ThomasKramp/kaarten_shieter/README.md

# kaarten_shieter
The documentation can be found in the Portfolio.

The PDF was generated using:
- The PDF version of the .md file Portfolio.
- An online md to pdf converter Converter
