ThomasKramp/kaarten_shieter/project_v2/feedback.docx

Elektronisch schema:

- Noteren welke connector waarvoor dient. O.a. power: input/output?
- Waar is de voeding? Extern?
- CE5: 470uF, waarom aan EN_P?
- Horizontale motor: 3,3V is dit correct?
- 470uF ontkoppeling aan ESP32 ontbreekt nog steeds.
- AISEN,BISEN: per pin één weerstand.

PCB:

- Montagegaten?
- Boorgaten: voor elecrow: stappen van 0,1mm (Zie DRL file)
- CE5 overlapt rand
- Design rules niet vergeten in te stellen. Clearance rule, annular ring rule geeft errors!
