ThomasKramp/kaarten_shieter/Portfolio/Images/module.jpeg

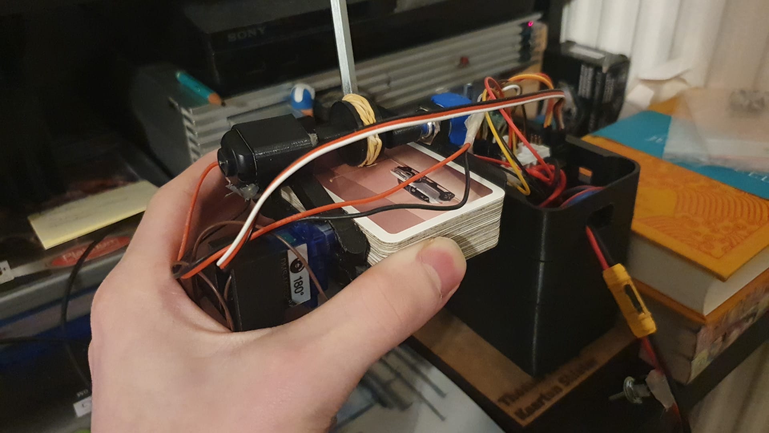
Portfolio/Images/module.jpeg
