ThomasKramp/kaarten_shieter/probleem_voeding/1_beginspanning_bron.png

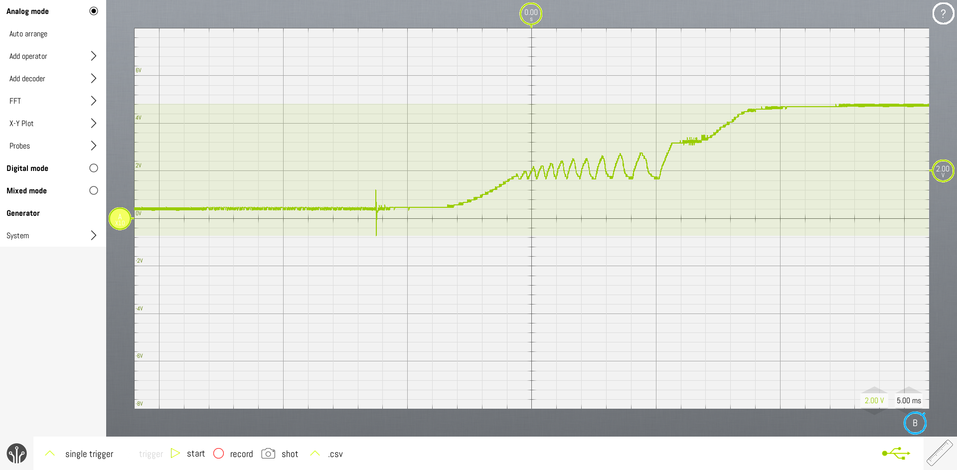
probleem_voeding/1_beginspanning_bron.png
