ThomasKramp/kaarten_shieter/probleem_voeding/2_beginspanning_batterij.png

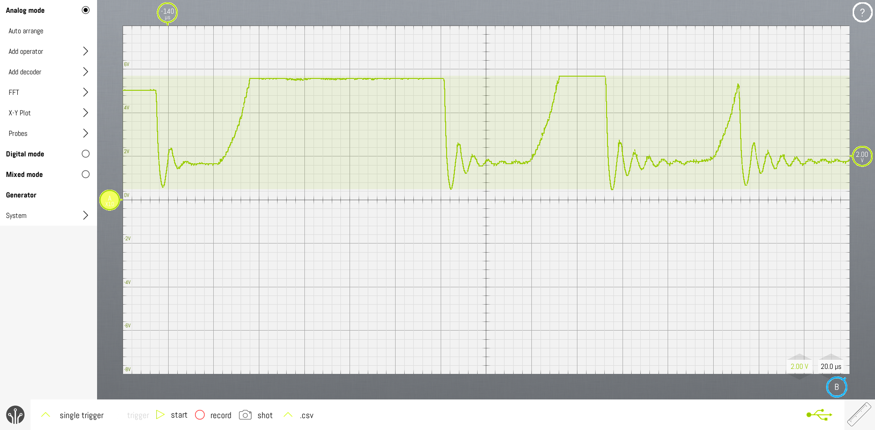
probleem_voeding/2_beginspanning_batterij.png
