ThomasKramp/kaarten_shieter/probleem_voeding/3_voeding_batterij.png

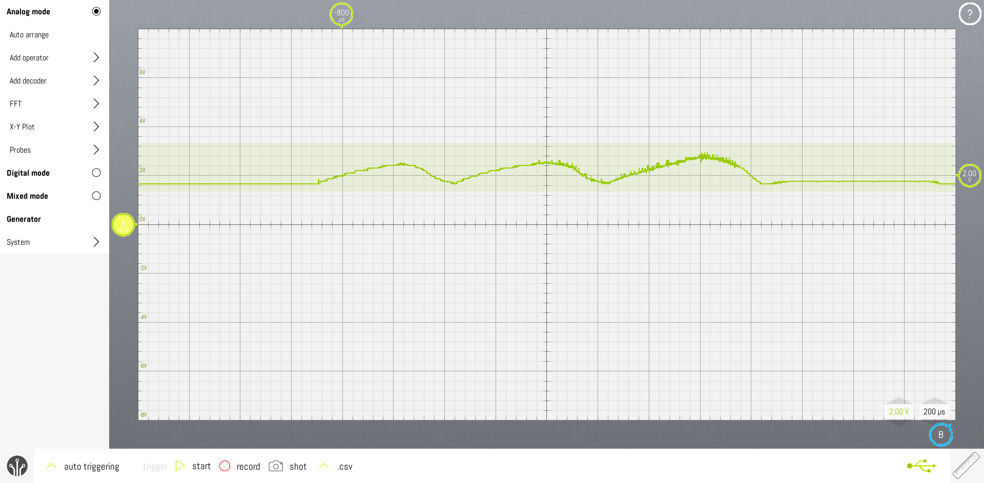
probleem_voeding/3_voeding_batterij.png
