ThomasKramp/kaarten_shieter/project_v3/back.png

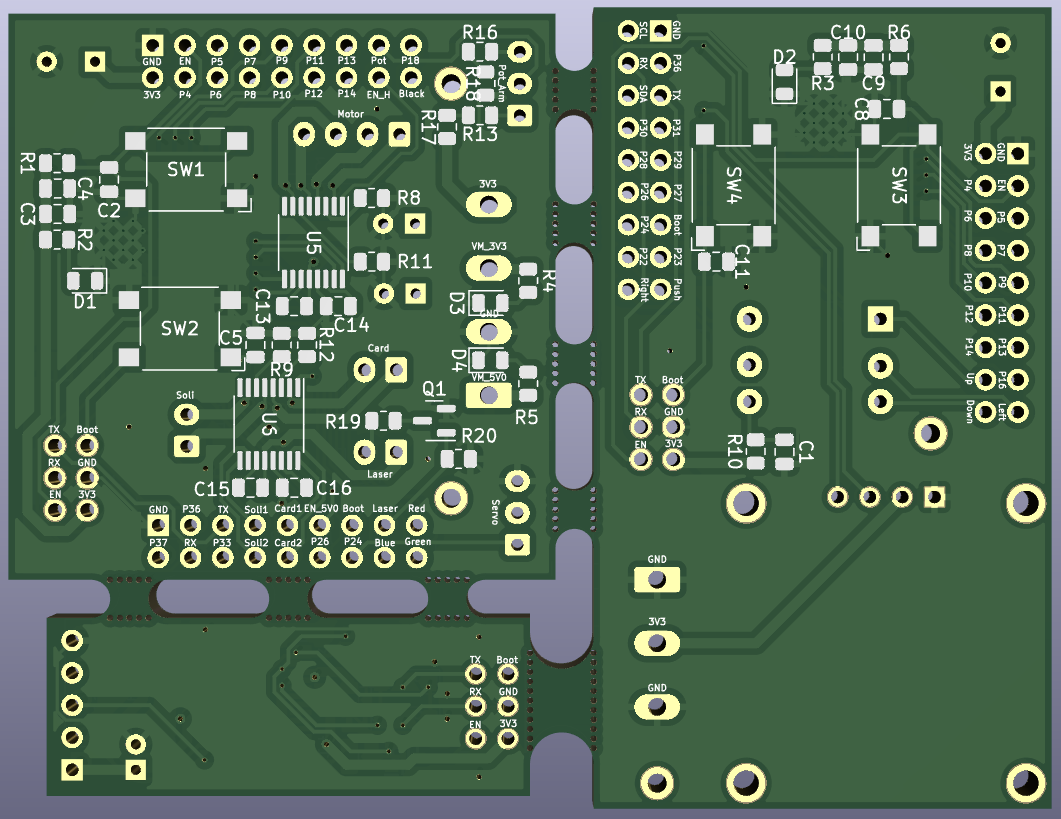
project_v3/back.png
