ThomasKramp/kaarten_shieter/project_v3/front.png

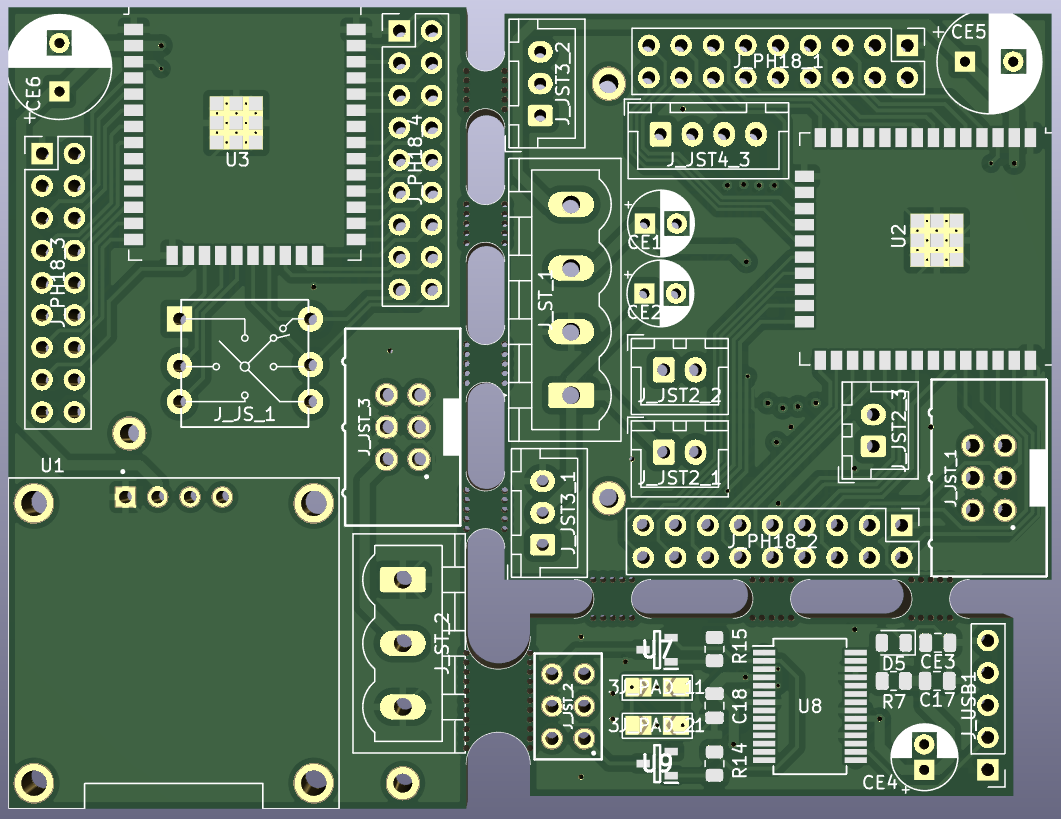
project_v3/front.png
