ThomasKramp/kaarten_shieter/3d_casing/stl/5_card_wheel.stl

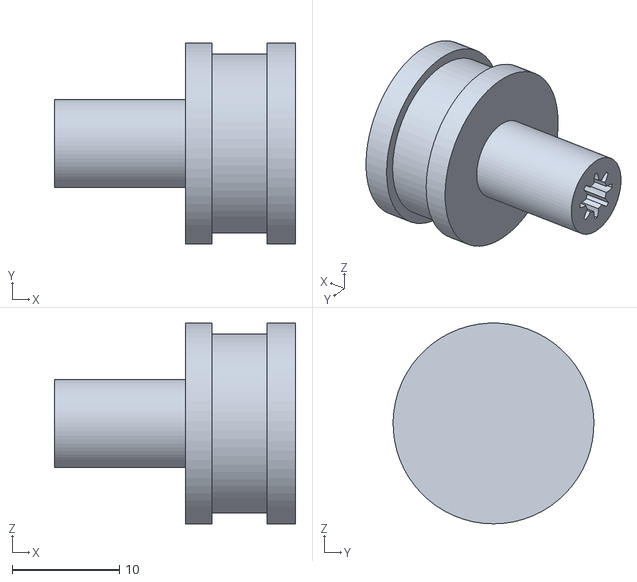
[picture p54: CAD file, 2025-01-09]
3d_casing/stl/5_card_wheel.stl
22.5 x 18.7 x 18.7
