ThomasKramp/kaarten_shieter/3d_casing/version_2/stl/4_sensor_holder.stl

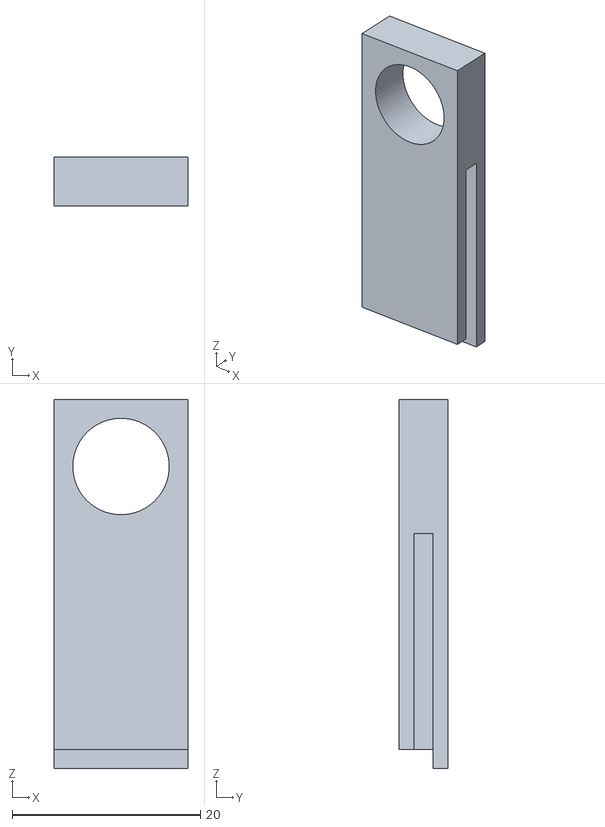
[picture p55: CAD file, 2024-11-24]
3d_casing/version_2/stl/4_sensor_holder.stl
14.2 x 5.25 x 39.2
