ThomasKramp/kaarten_shieter/laser_cutter/plate.dxf

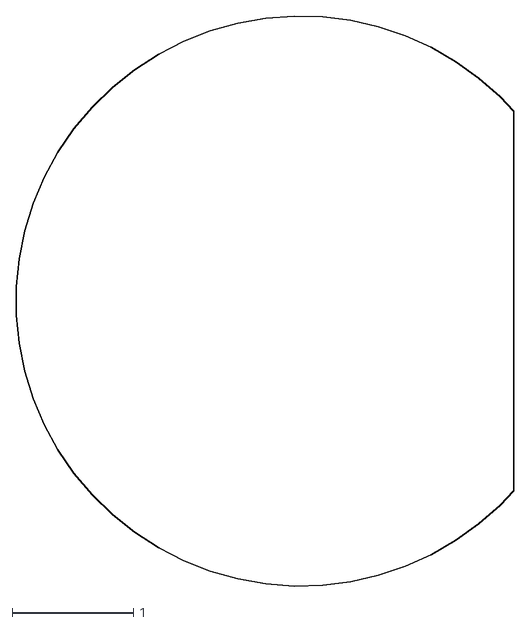
[picture p56: CAD file, 2025-01-09]
laser_cutter/plate.dxf
4.10 x 4.70
