ThomasKramp/kaarten_shieter/3d_casing/stl/5_solinoid_holder.stl

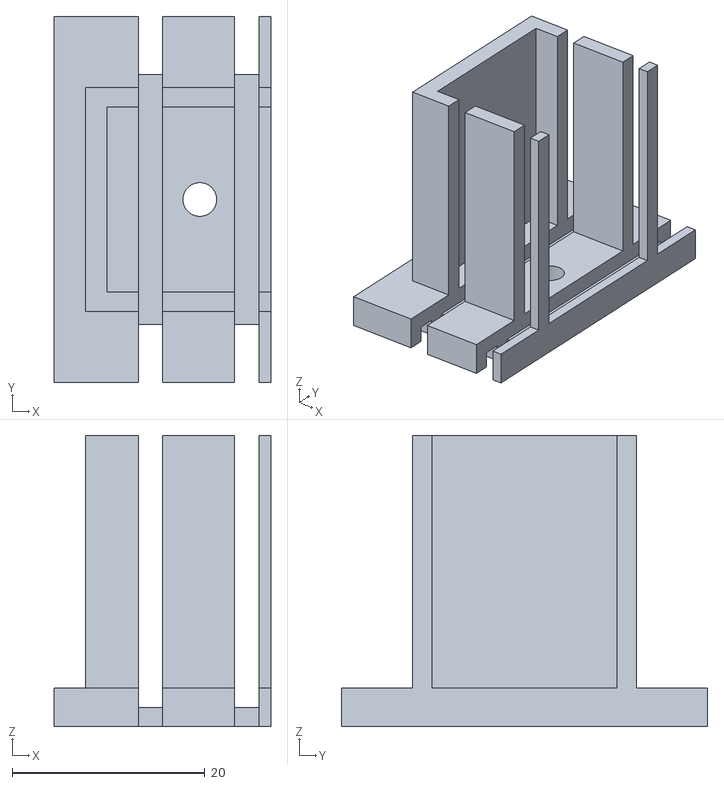
[picture p57: CAD file, 2024-11-24]
3d_casing/stl/5_solinoid_holder.stl
22.5 x 38.0 x 30.2
