ThomasKramp/kaarten_shieter/3d_casing/version_2/stl/5_pillars.stl

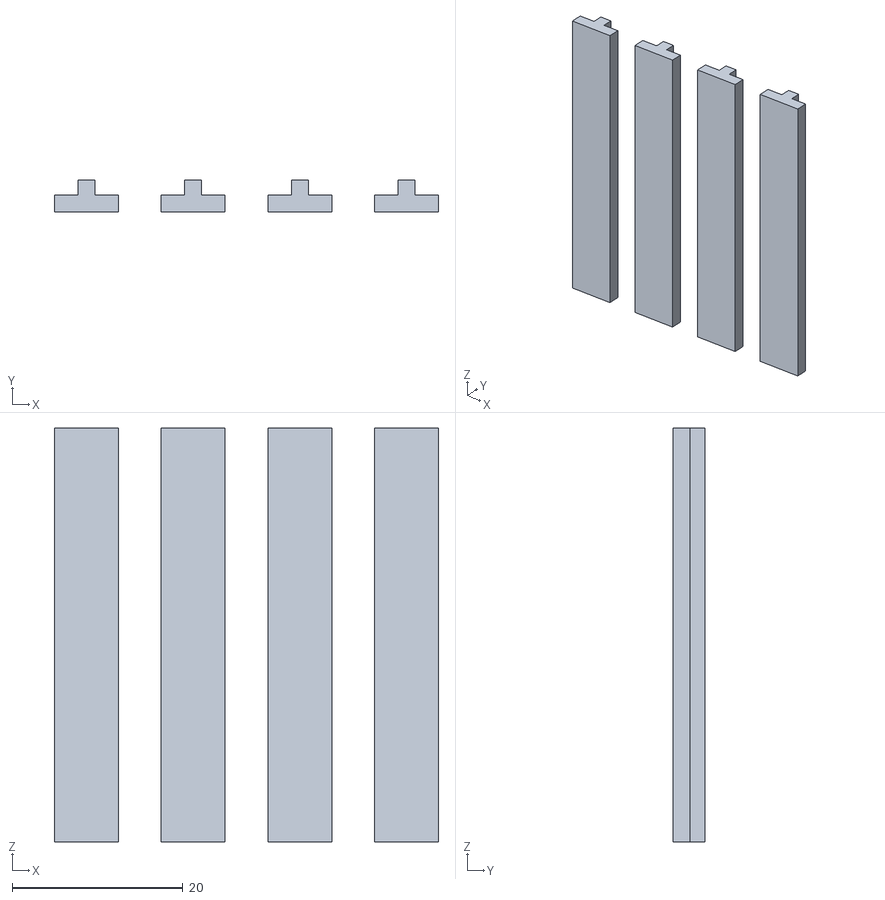
[picture p58: CAD file, 2024-11-24]
3d_casing/version_2/stl/5_pillars.stl
45.0 x 3.75 x 48.5
