ThomasKramp/kaarten_shieter/3d_casing/stl/3_box_level_2.stl

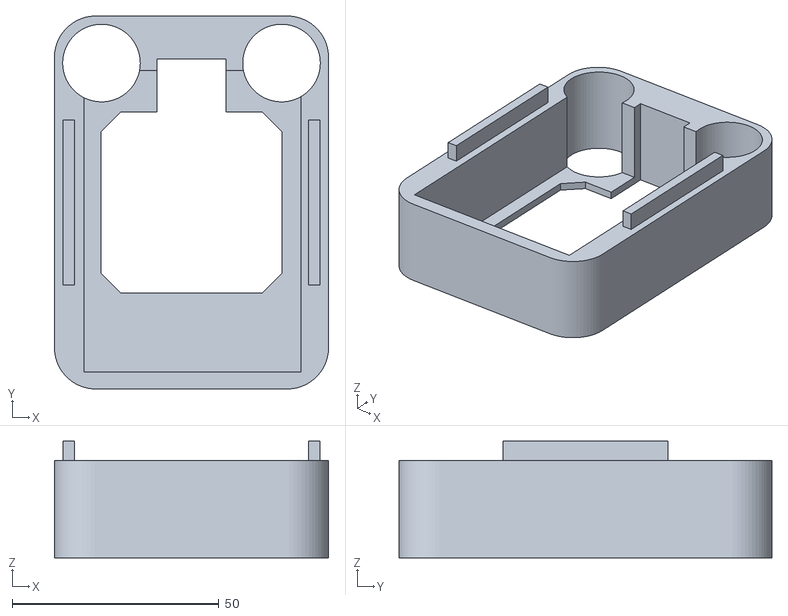
[picture p59: CAD file, 2024-11-24]
3d_casing/stl/3_box_level_2.stl
66.2 x 90.1 x 28.2
