ThomasKramp/kaarten_shieter/3d_casing/stl/6_lid.stl

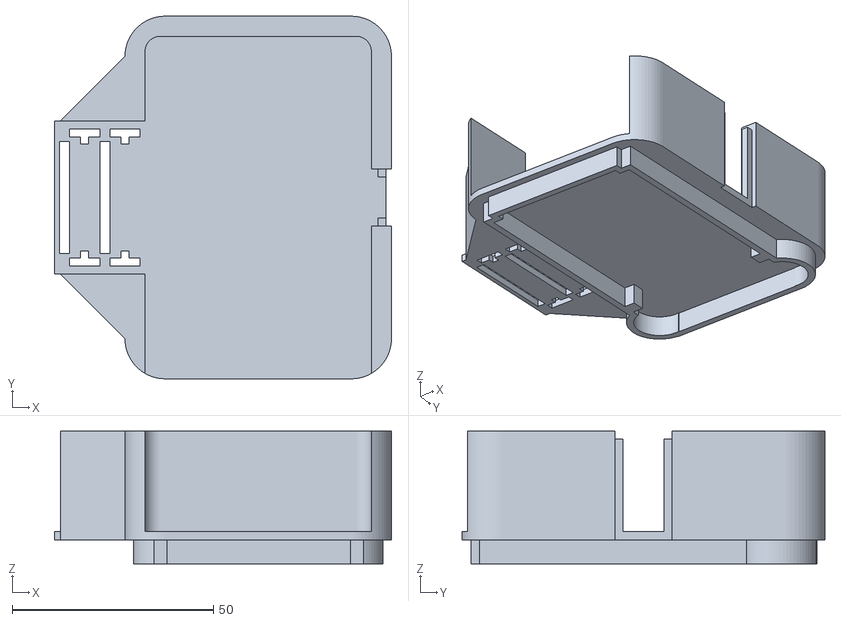
[picture p60: CAD file, 2024-11-24]
3d_casing/stl/6_lid.stl
83.8 x 90.1 x 33.0
