ThomasKramp/kaarten_shieter/3d_casing/version_2/stl/2_converter.stl

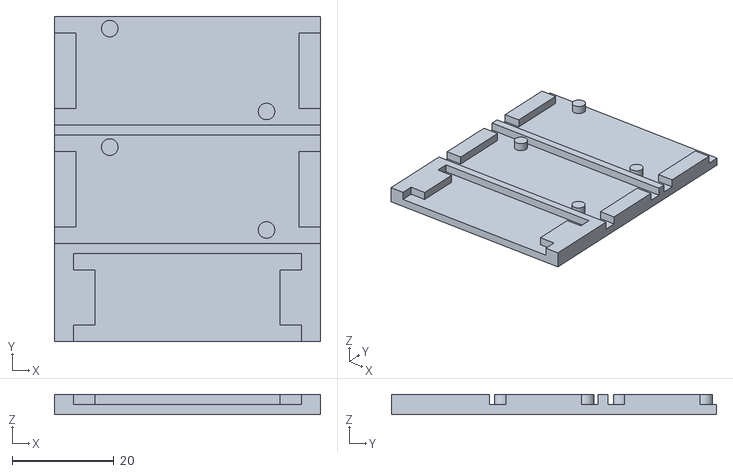
[picture p61: CAD file, 2024-11-24]
3d_casing/version_2/stl/2_converter.stl
52.2 x 63.8 x 4.00
