ThomasKramp/kaarten_shieter/3d_casing/version_2/stl/5_card_motor_holder.stl

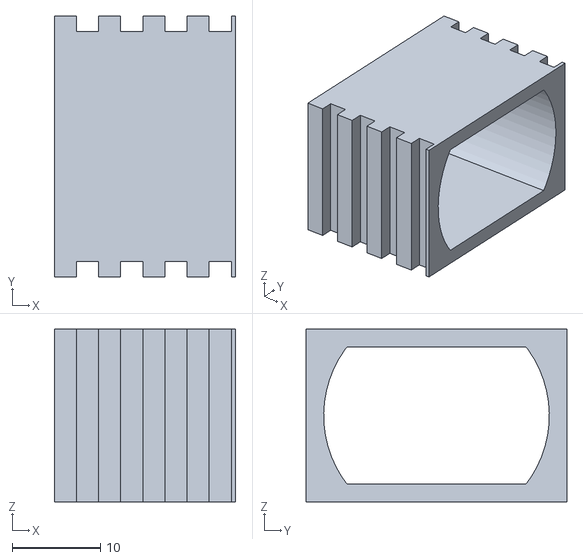
[picture p63: CAD file, 2024-11-24]
3d_casing/version_2/stl/5_card_motor_holder.stl
20.5 x 29.5 x 19.5
