ThomasKramp/kaarten_shieter/3d_casing/stl/3_box_level_1.stl

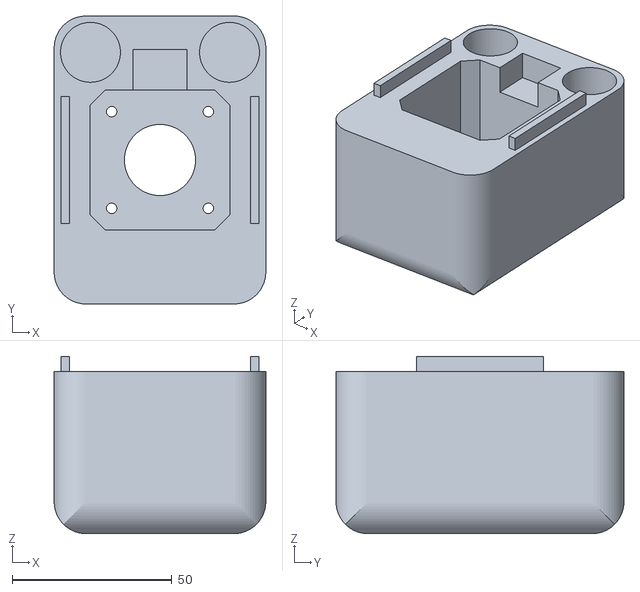
[picture p64: CAD file, 2024-11-24]
3d_casing/stl/3_box_level_1.stl
66.2 x 90.1 x 55.5
