ThomasKramp/kaarten_shieter/3d_casing/version_2/stl/5_card_wheel.stl

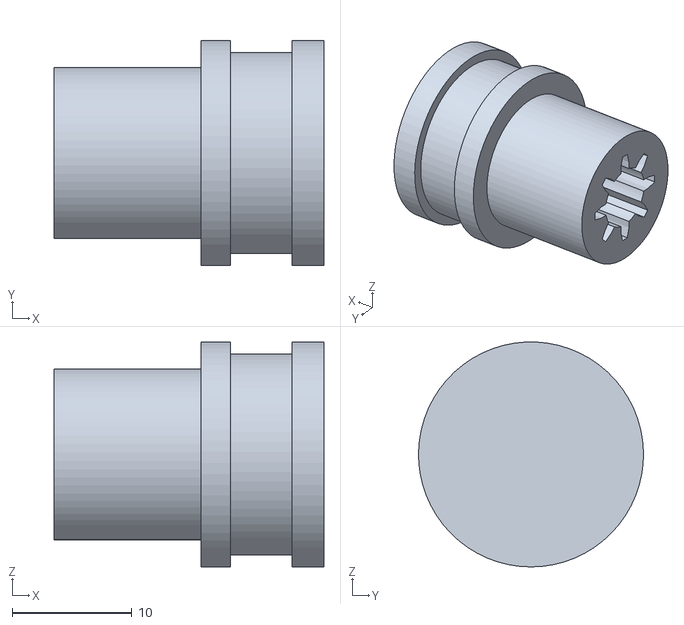
[picture p65: CAD file, 2024-11-24]
3d_casing/version_2/stl/5_card_wheel.stl
22.5 x 18.7 x 18.7
