ThomasKramp/kaarten_shieter/3d_casing/version_2/stl/1_pcb.stl

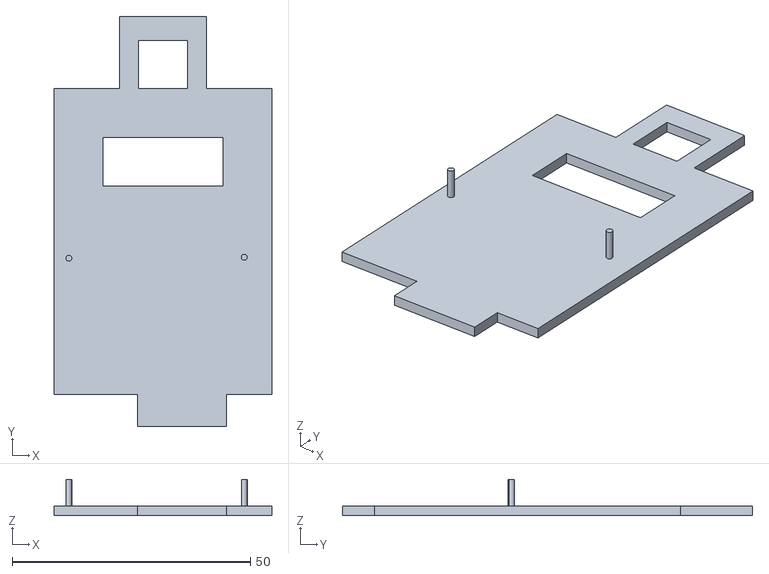
[picture p66: CAD file, 2024-11-24]
3d_casing/version_2/stl/1_pcb.stl
45.8 x 86.1 x 7.62
