ThomasKramp/kaarten_shieter/(list of files, cad)

Other CAD files:
3d_casing/0_settings.scad
3d_casing/version_2/0_settings.scad
3d_casing/5_shooter_mount.scad
3d_casing/version_2/3_box.scad
3d_casing/version_2/6_lid.scad
3d_casing/version_1/0_casing.scad
3d_casing/version_1/0_corner_cutout.scad
3d_casing/version_1/1_0_box.scad
3d_casing/version_1/1_1_motor.scad
3d_casing/version_1/1_2_battery.scad
3d_casing/version_1/1_3_charger.scad
3d_casing/version_1/2_0_buck_plate.scad
3d_casing/version_1/2_1_buck_converter.scad
3d_casing/version_1/3_0_pcb_plate.scad
3d_casing/version_1/3_1_pcb.scad
3d_casing/version_1/4_0_lid.scad
3d_casing/version_1/4_1_mounts.scad
3d_casing/version_1/4_2_card_deck.scad
3d_casing/version_1/4_3_0_shooter_tower.scad
3d_casing/version_1/4_3_1_card_motor_holder.scad
3d_casing/version_1/4_3_2_card_wheel.scad
3d_casing/version_1/4_4_0_pot_holder.scad
3d_casing/version_1/4_4_1_pot_arm.scad
3d_casing/version_1/stl/1_0_box.stl
3d_casing/version_1/stl/2_0_buck_plate.stl
3d_casing/version_1/stl/3_0_pcb_plate.stl
3d_casing/version_1/stl/4_0_lid.stl
3d_casing/version_1/stl/4_3_2_card_wheel.stl
3d_casing/version_1/stl/4_3_shooter_tower.stl
3d_casing/version_1/stl/4_4_1_pot_arm.stl
3d_casing/version_1/stl/4_4_pot_holder.stl
