ThomasKramp/kaarten_shieter/Portfolio/Schematic/schematic.pdf

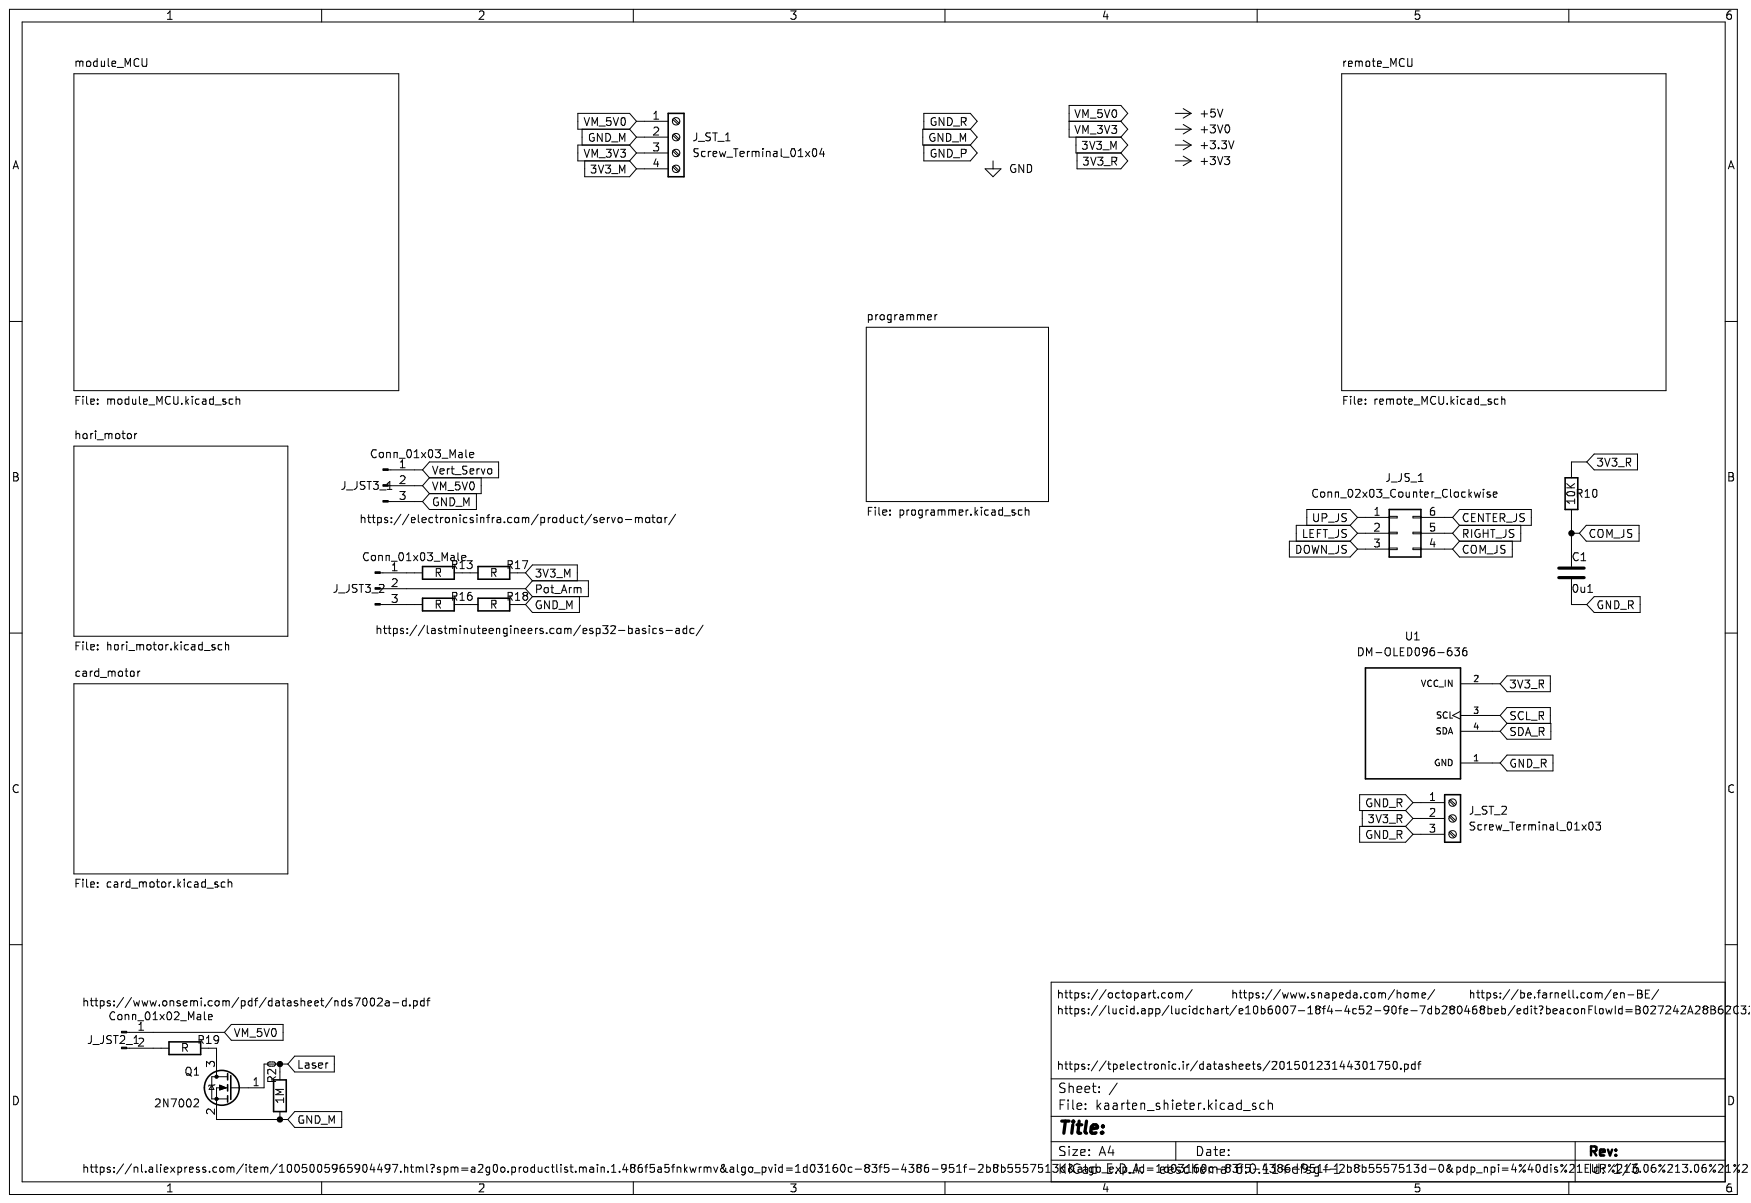
[picture p67: page 1]

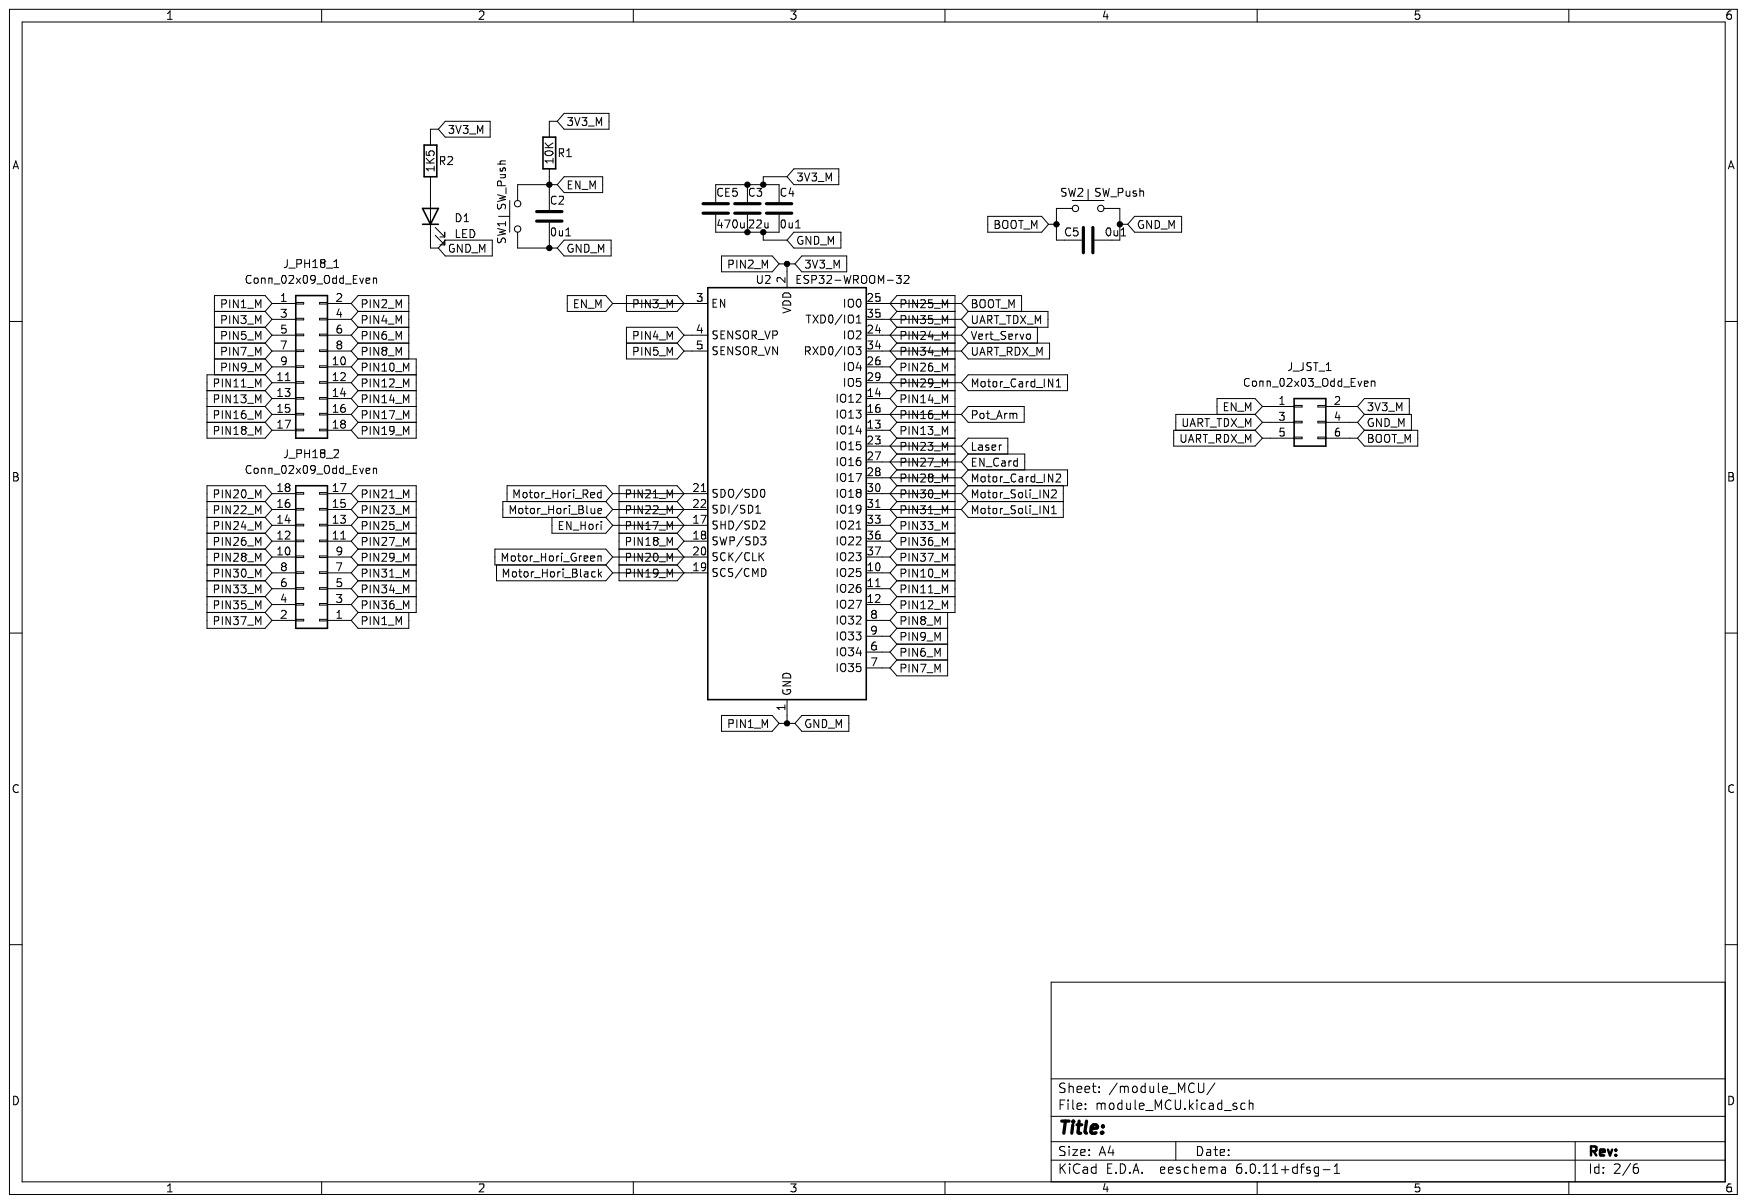
[picture p68: page 2]

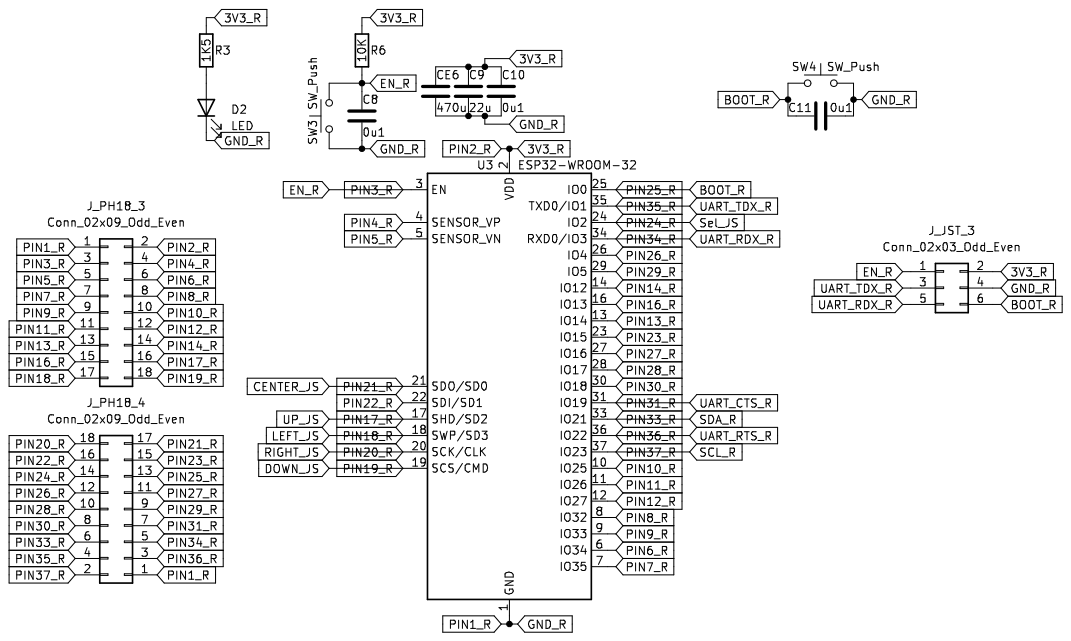
[picture p69: page 3]

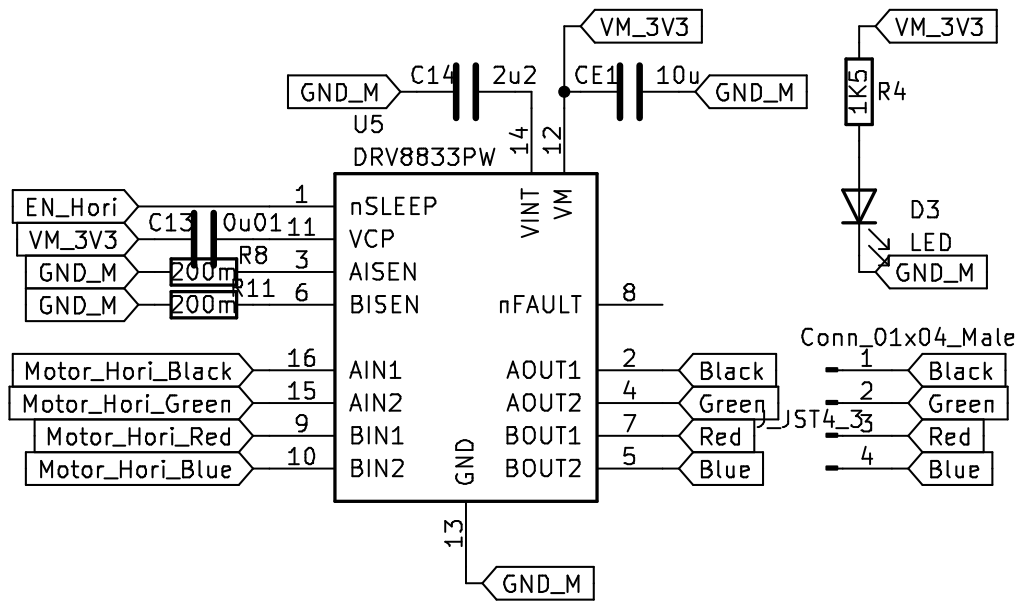
[picture p70: page 4]

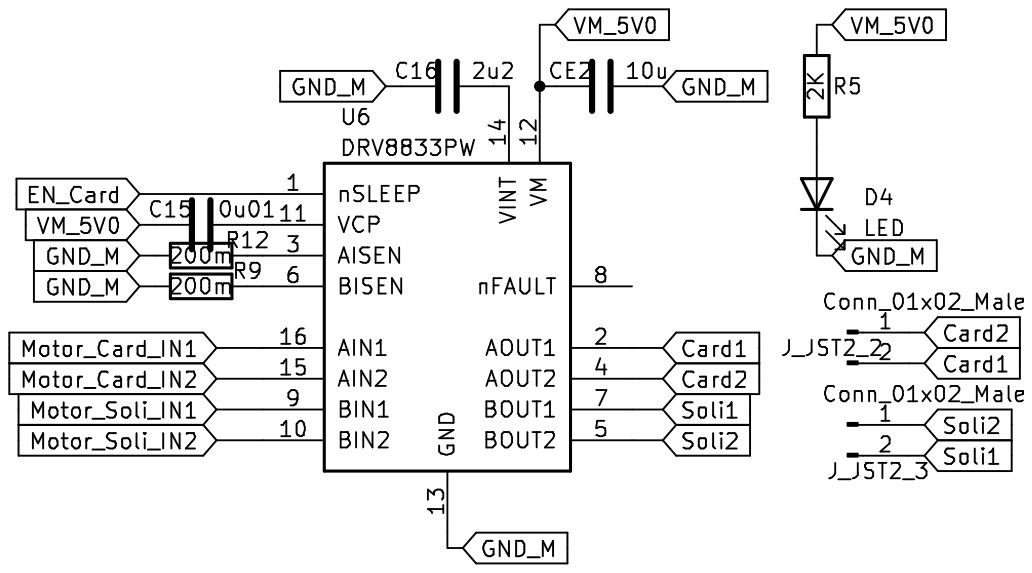
[picture p71: page 5]

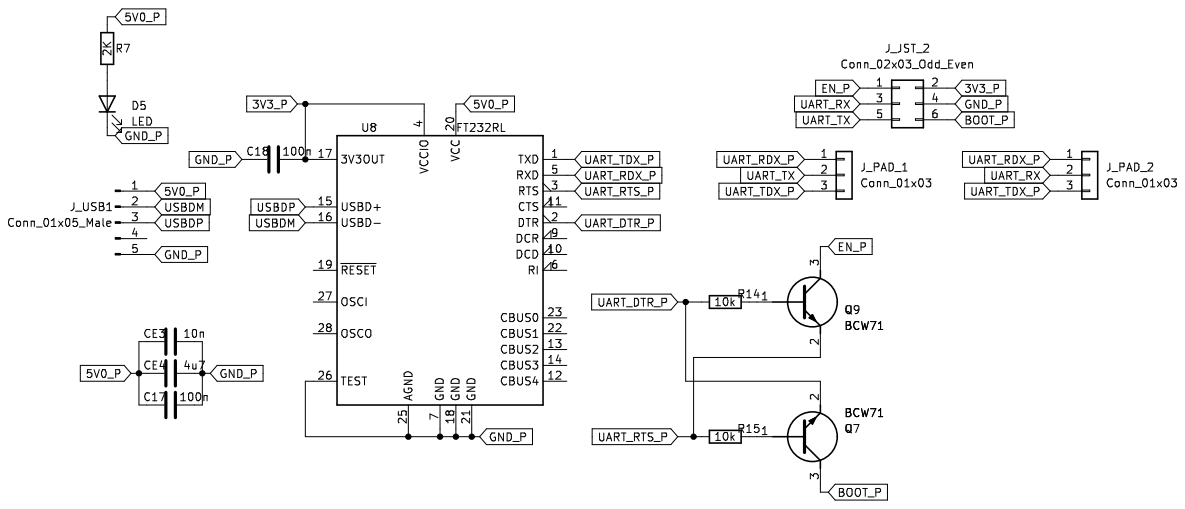
[picture p72: page 6]
