ThomasKramp/kaarten_shieter/project_v3/schema.pdf

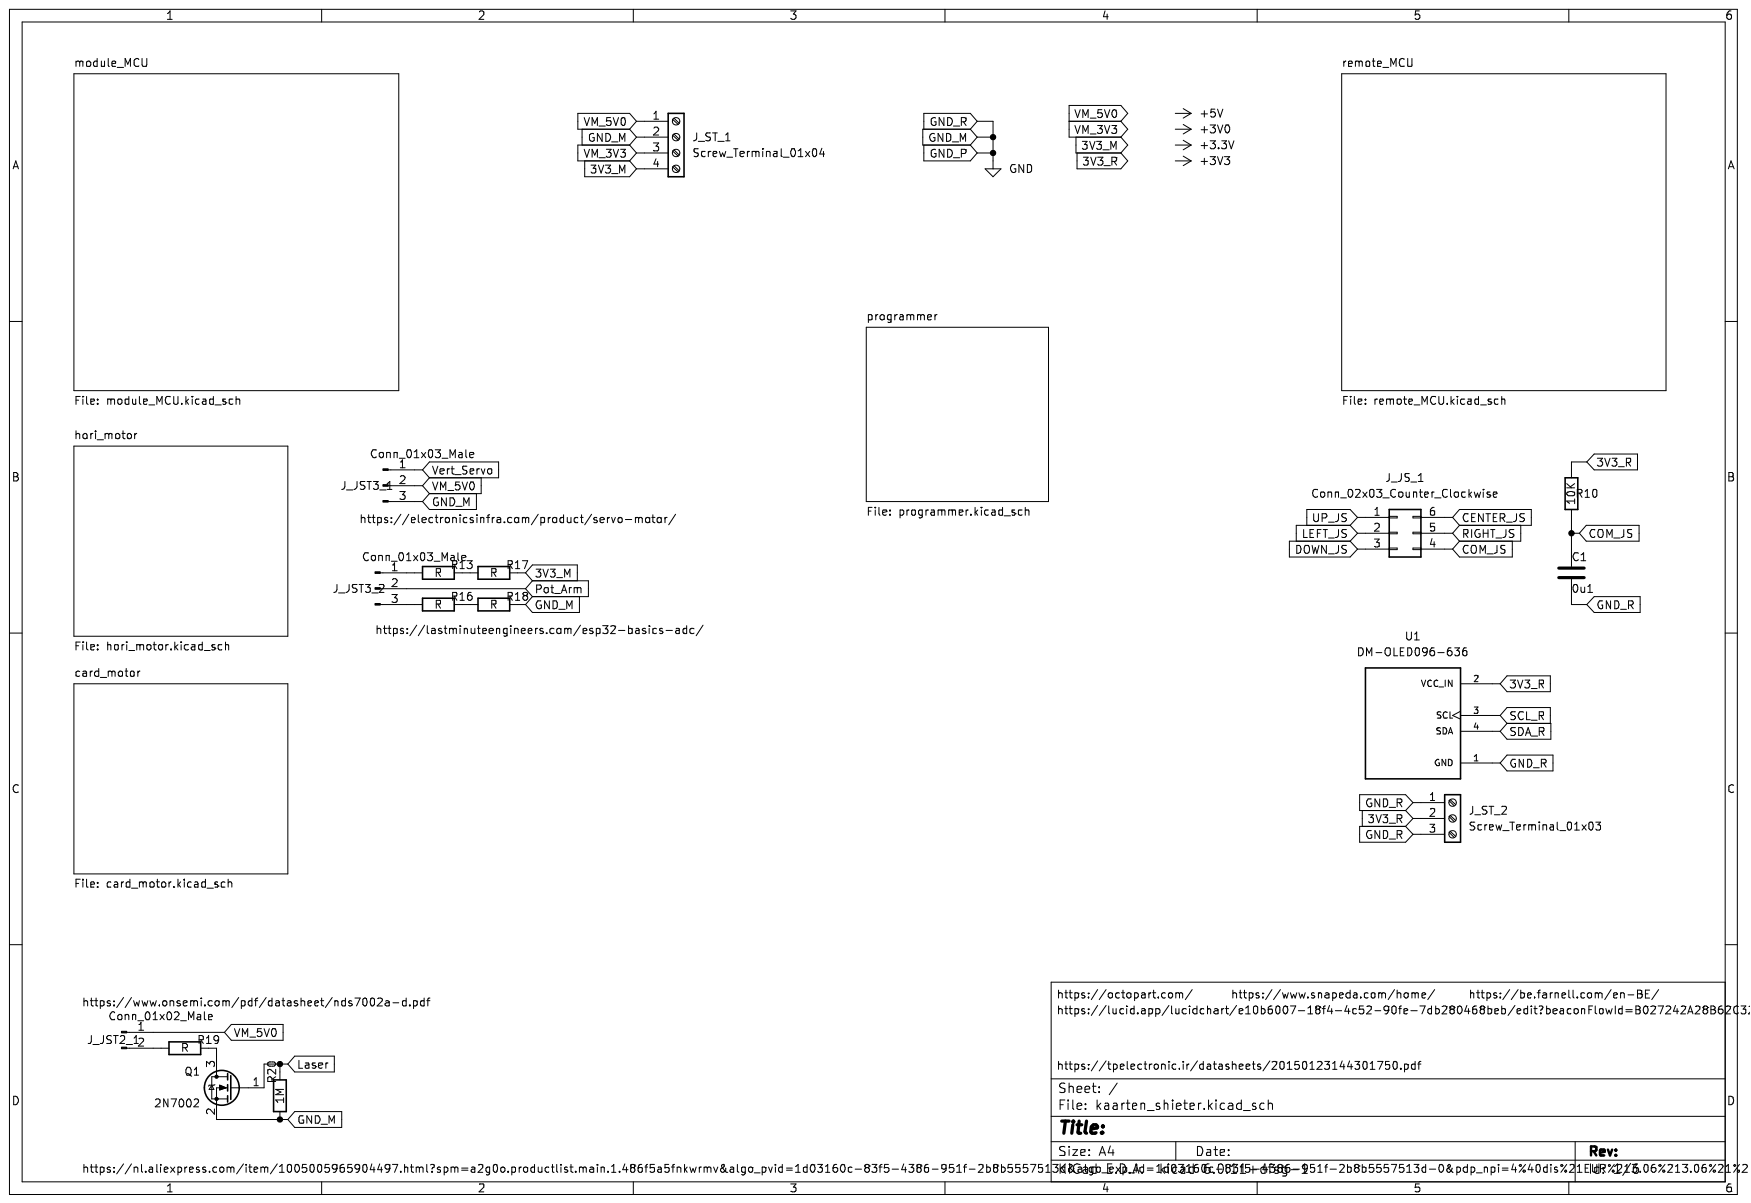
[picture p73: page 1]

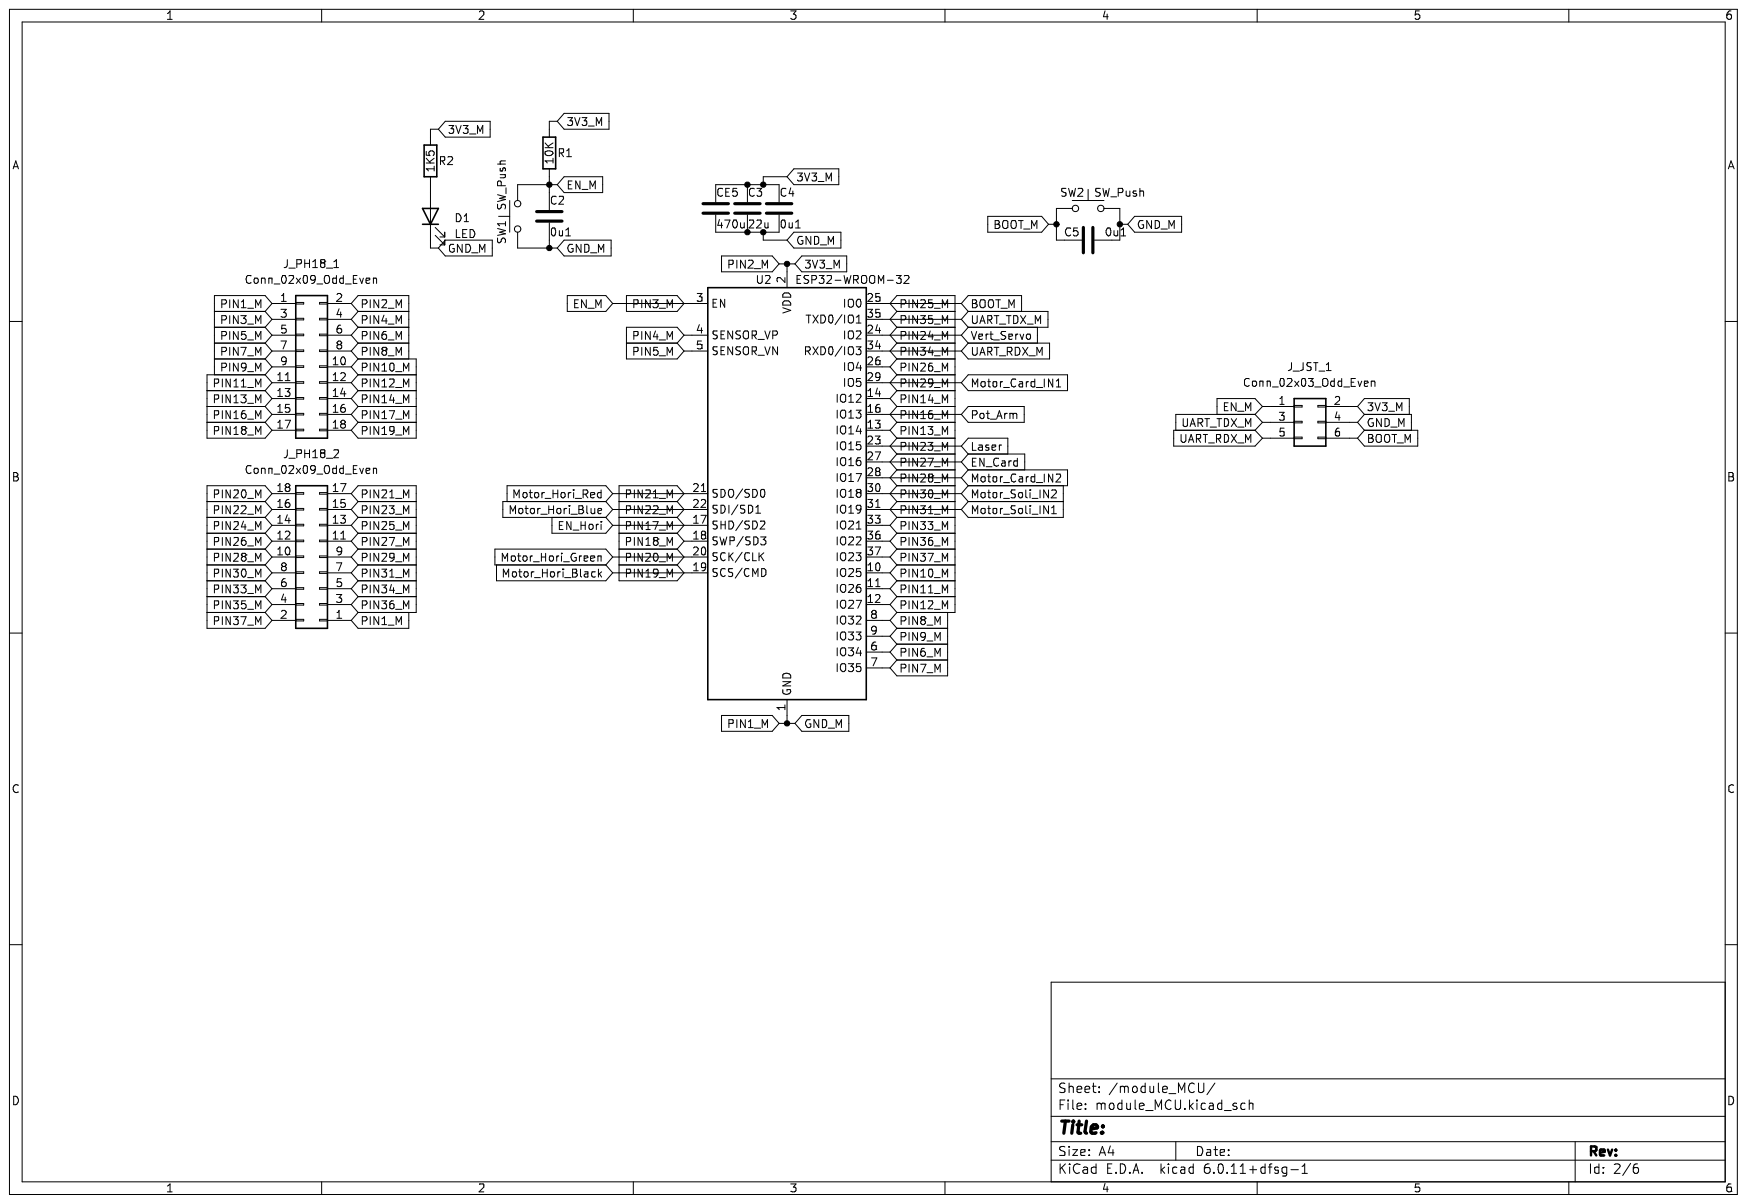
[picture p74: page 2]
