ThomasKramp/kaarten_shieter/project_v1/schematic_v1.pdf

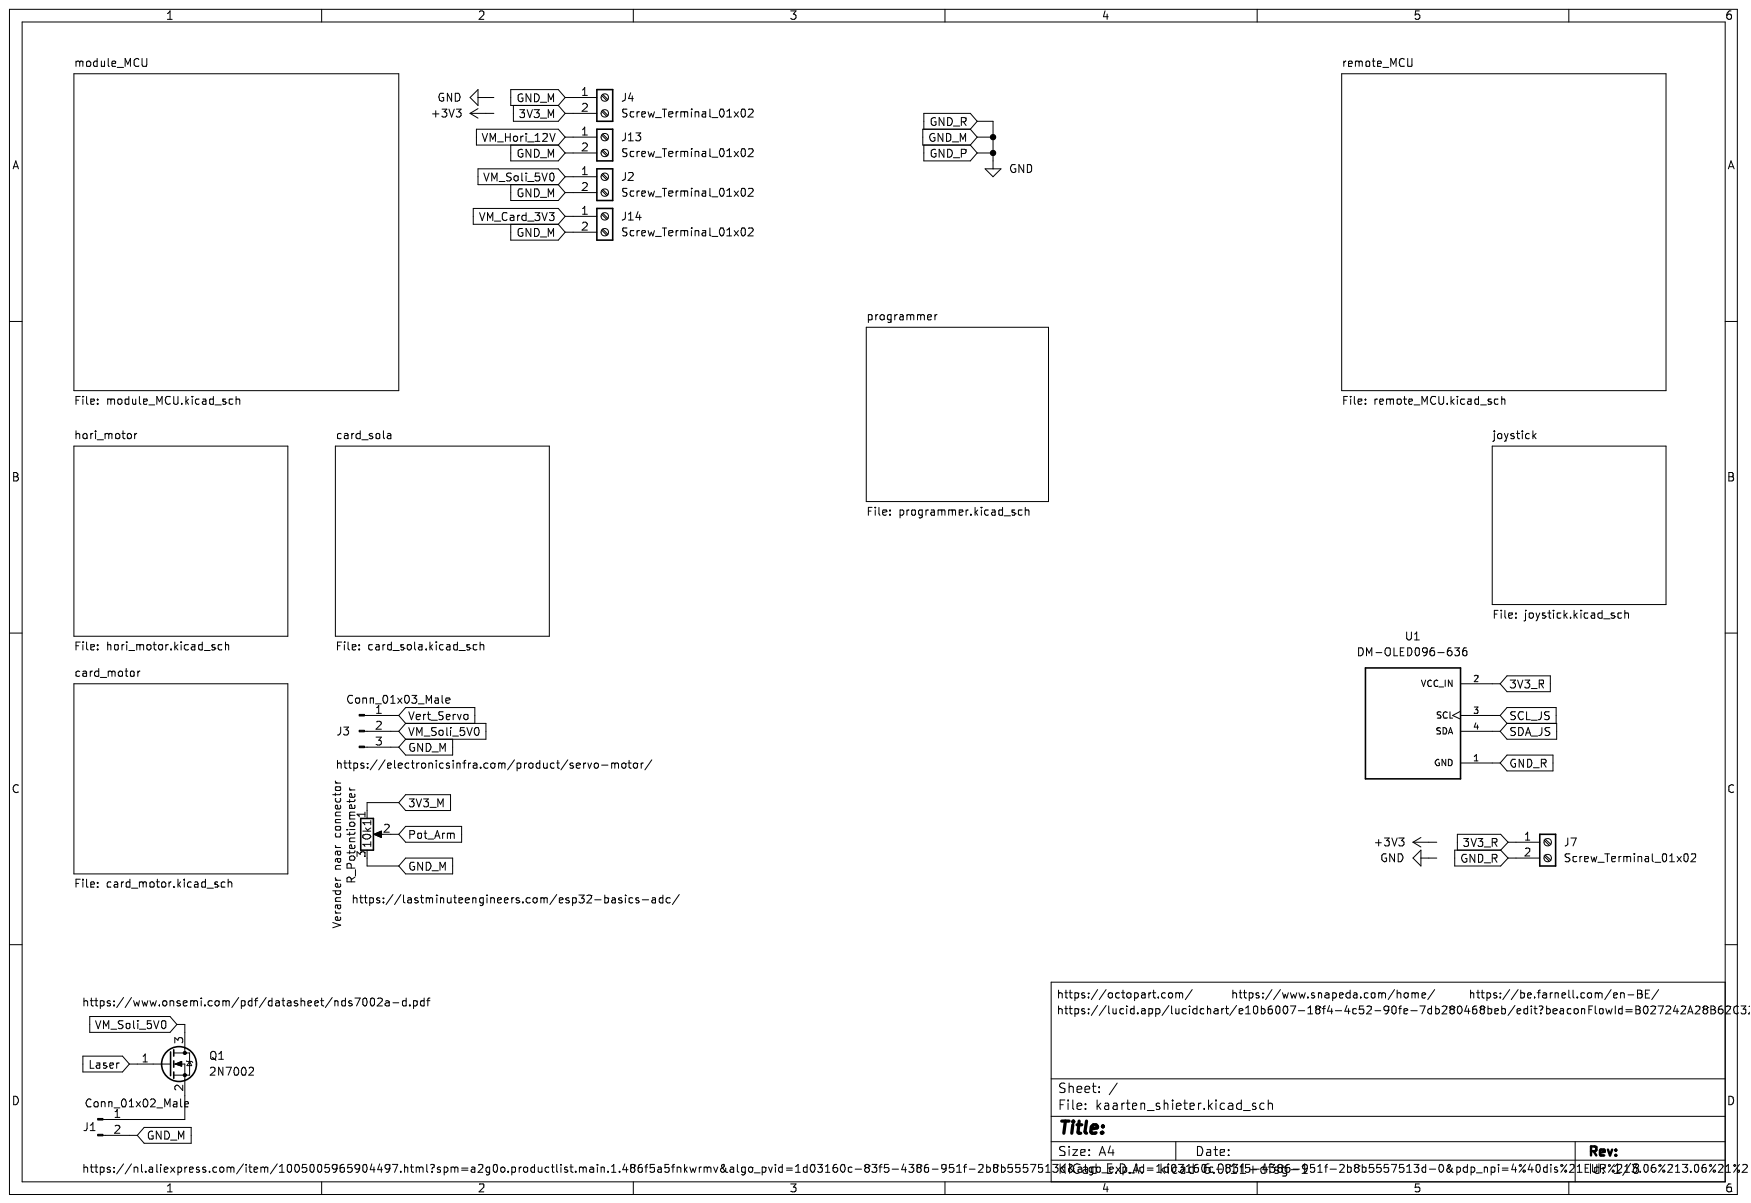
[picture p82: page 1]

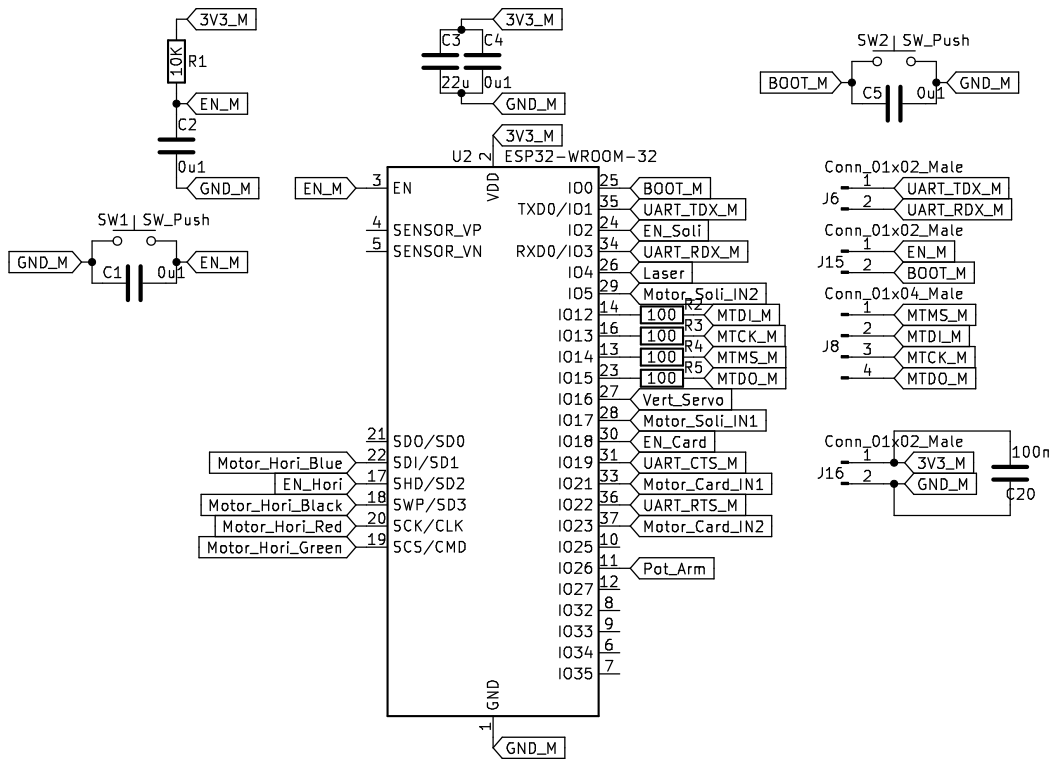
[picture p83: page 2]

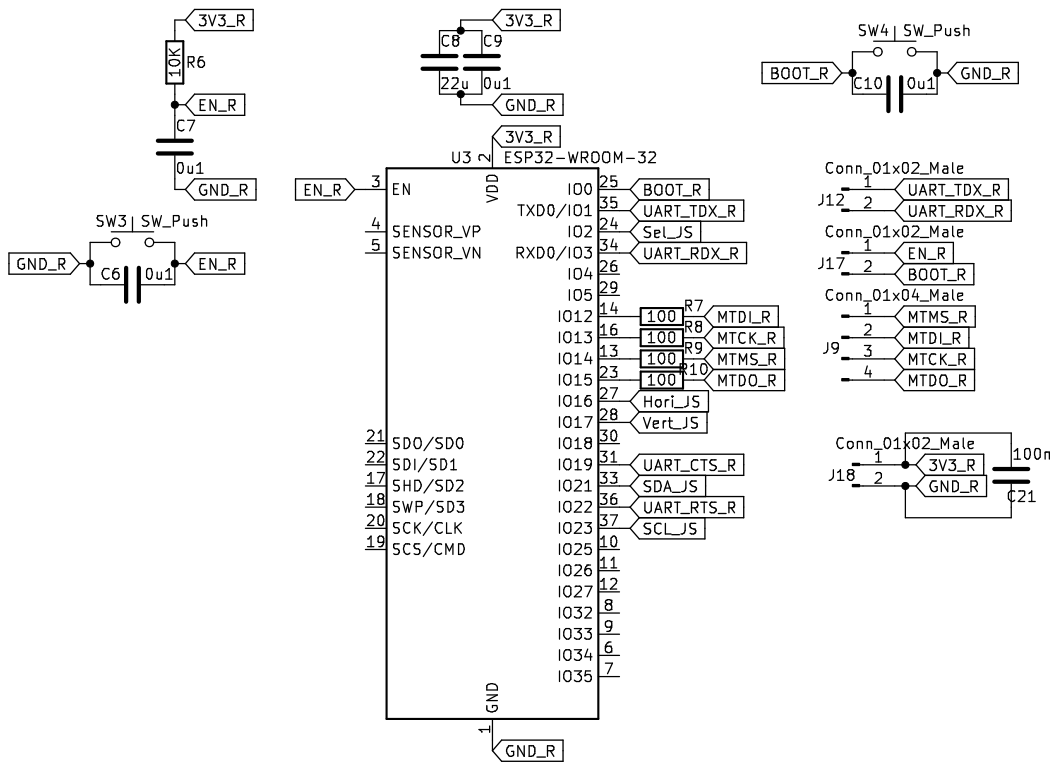
[picture p84: page 3]


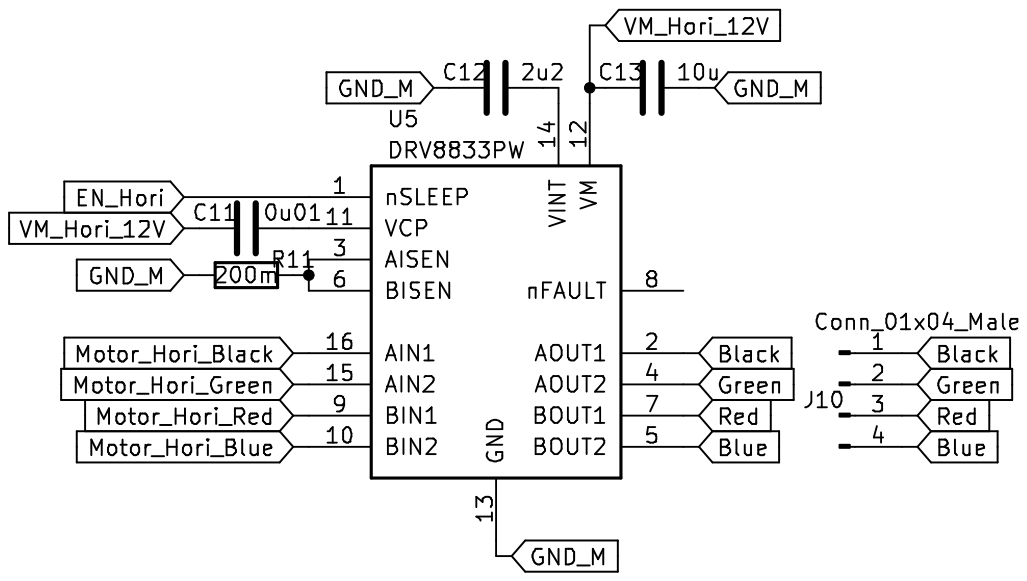
[picture p85: page 5]

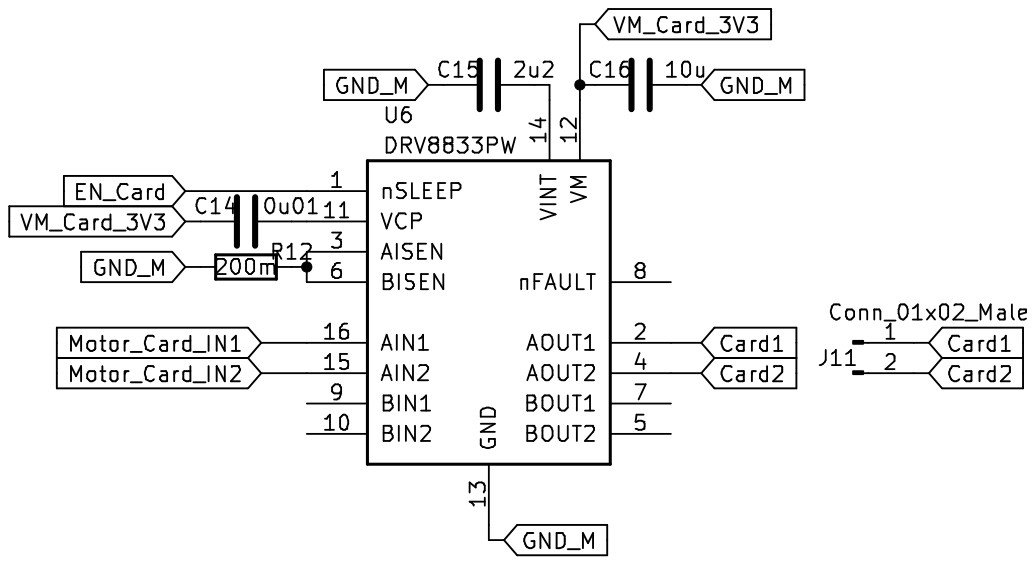
[picture p86: page 6]

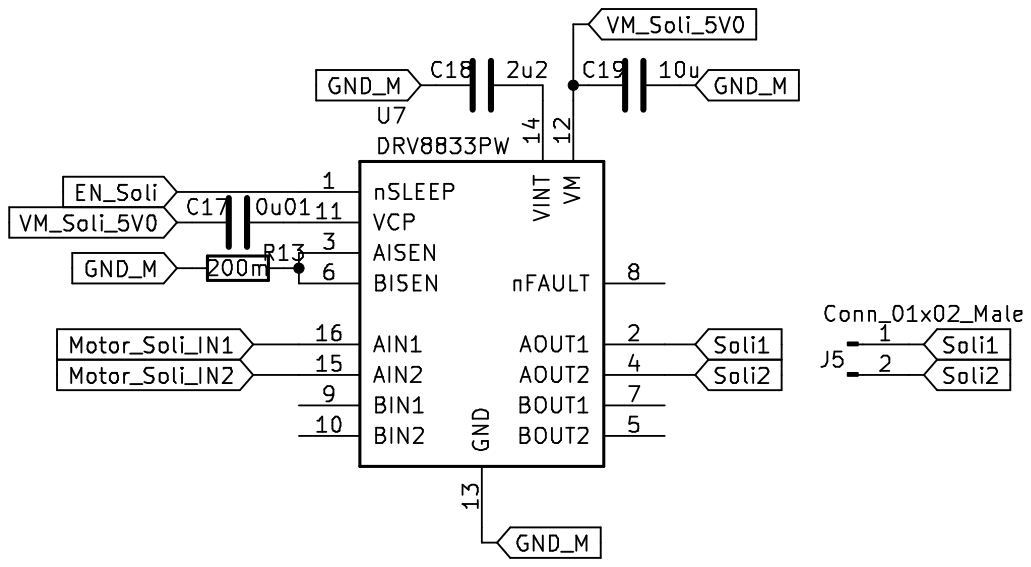
[picture p87: page 7]

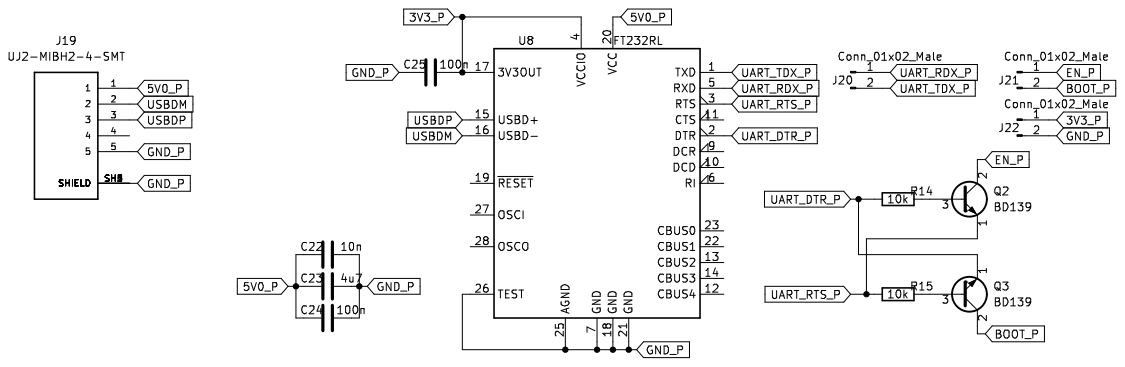
[picture p88: page 8]
