ThomasKramp/kaarten_shieter/schema/kaarten_schieter/kaarten_shieter.kicad_pcb

## KiCad design schema/kaarten_schieter/kaarten_shieter.kicad_pcb (2024-11-21)

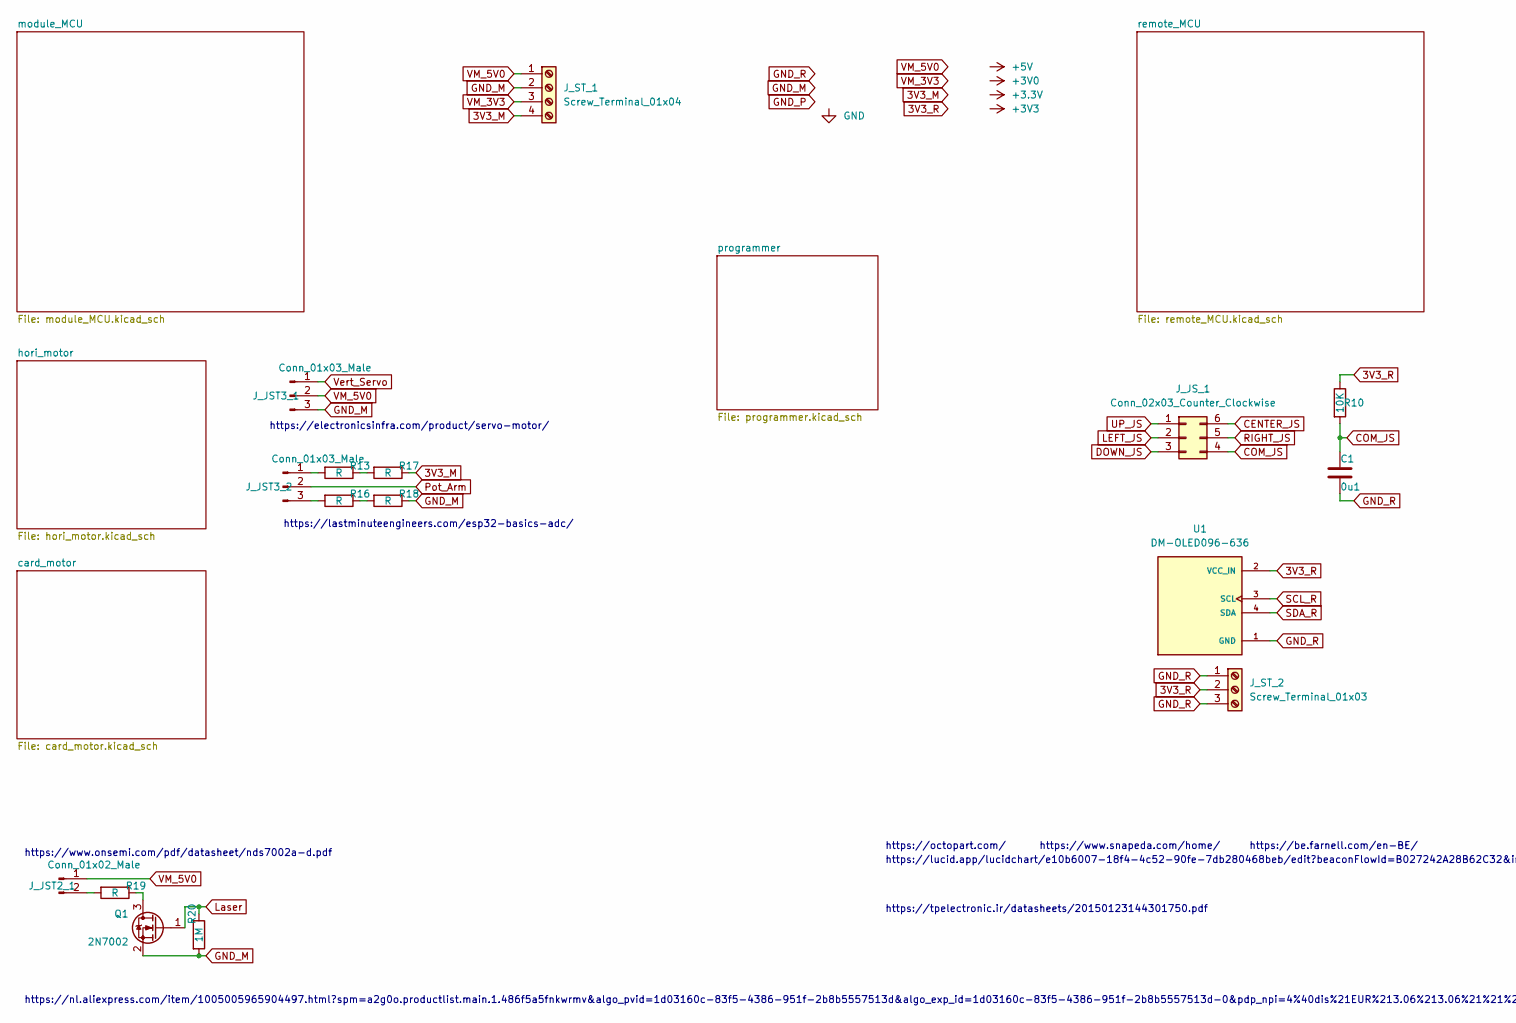
[picture p89: schematic kaarten_shieter.kicad_sch, part in row 1, column 1]

Parts:
C1: 0u1; C_0805_2012Metric
J_JST2_1: Conn_01x02_Male; JST_XH_B2B-XH-A_1x02_P2.50mm_Vertical
J_JST3_1, J_JST3_2: Conn_01x03_Male; JST_XH_B3B-XH-A_1x03_P2.50mm_Vertical
J_JS_1: Conn_02x03_Counter_Clockwise; JS_SKQUCAA010
J_ST_1: Screw_Terminal_01x04; PhoenixContact_MSTBVA_2,5_4-G_1x04_P5.00mm_Vertical
J_ST_2: Screw_Terminal_01x03; PhoenixContact_MSTBVA_2,5_3-G_1x03_P5.00mm_Vertical
Q1: 2N7002; SOT-23
R10: 10K; R_0805_2012Metric
R13, R16, R17, R18, R19: R; R_0805_2012Metric
R20: 1M; R_0805_2012Metric
U1: DM-OLED096-636; MODULE_DM-OLED096-636; PARTREV 2018-09-10

Connections:
3V3_M: J_ST_1.4, R17.1; also elsewhere on the board
3V3_R: J_ST_2.2, R10.1, U1.2 (VCC_IN); also elsewhere on the board
CENTER_JS: J_JS_1.6; also elsewhere on the board
COM_JS: C1.1, J_JS_1.4, R10.2
DOWN_JS: J_JS_1.3; also elsewhere on the board
GND_M: J_JST3_1.3, J_ST_1.2, Q1.2 (S), R18.1, R20.2; also elsewhere on the board
GND_R: C1.2, J_ST_2.1, J_ST_2.3, U1.1 (GND); also elsewhere on the board
LEFT_JS: J_JS_1.2; also elsewhere on the board
Laser: Q1.1 (G), R20.1; also elsewhere on the board
unnamed: J_JST2_1.2, R19.2
unnamed: J_JST3_2.1, R13.2
unnamed: J_JST3_2.3, R16.2
unnamed: Q1.3 (D), R19.1
unnamed: R13.1, R17.2
unnamed: R16.1, R18.2
PIN16_M: J_JST3_2.2; also elsewhere on the board
PIN17_R: J_JS_1.1; also elsewhere on the board
PIN20_R: J_JS_1.5; also elsewhere on the board
PIN24_M: J_JST3_1.1; also elsewhere on the board
PIN33_R: U1.4 (SDA); also elsewhere on the board
PIN37_R: U1.3 (SCL); also elsewhere on the board
VM_3V3: J_ST_1.3; also elsewhere on the board
VM_5V0: J_JST2_1.1, J_JST3_1.2, J_ST_1.1; also elsewhere on the board

Notes on the sheet:
https://nl.aliexpress.com/item/1005005965904497.html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…
https://lucid.app/lucidchart/e10b6007-18f4-4c52-90fe-7db280468beb/edit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
https://octopart.com/
https://tpelectronic.ir/datasheets/20150123144301750.pdf
https://lastminuteengineers.com/esp32-basics-adc/
https://electronicsinfra.com/product/servo-motor/
https://be.farnell.com/en-BE/
https://www.onsemi.com/pdf/datasheet/nds7002a-d.pdf
https://www.snapeda.com/home/

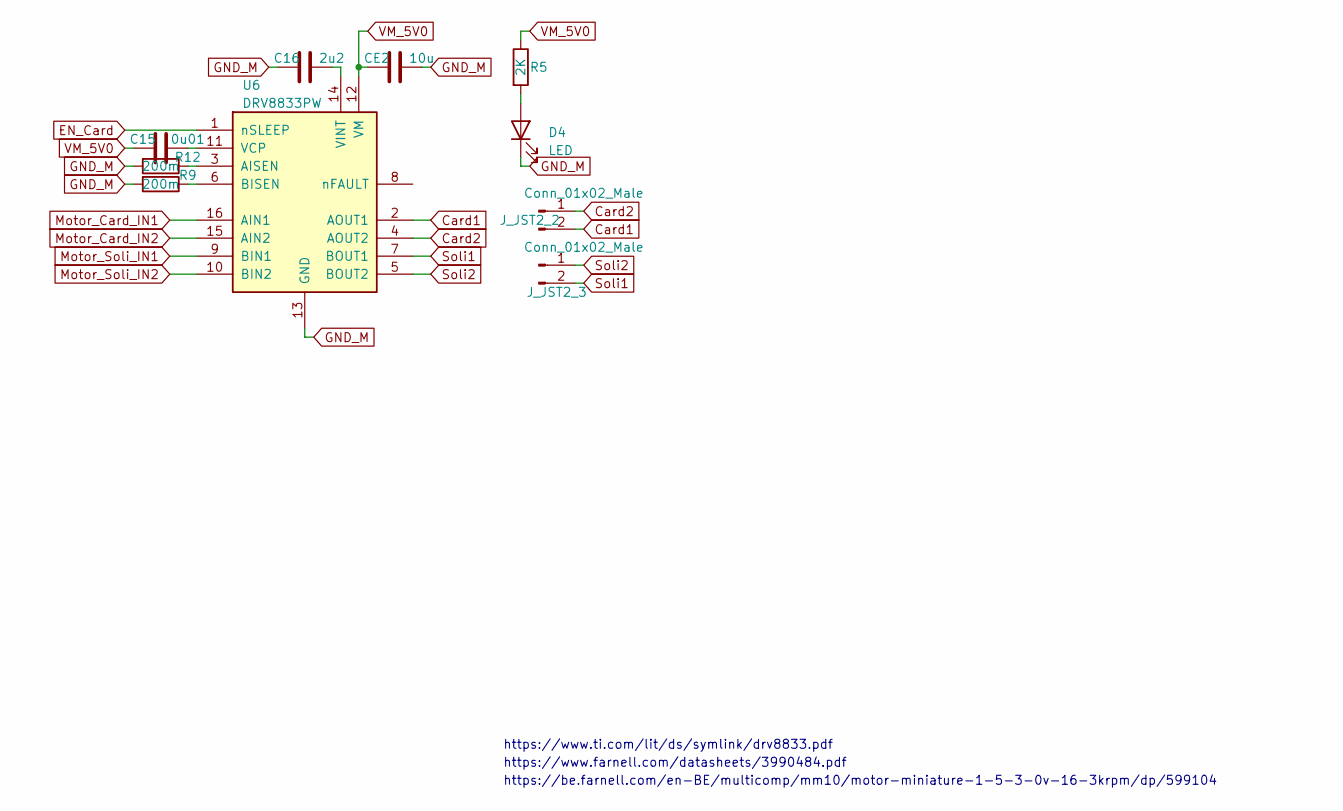
[picture p90: schematic card_motor.kicad_sch]

Parts:
C15: 0u01; C_0805_2012Metric
C16: 2u2; C_0805_2012Metric
CE2: 10u; CP_Radial_D5.0mm_P2.50mm
D4: LED; LED_0805_2012Metric
J_JST2_2, J_JST2_3: Conn_01x02_Male; JST_XH_B2B-XH-A_1x02_P2.50mm_Vertical
R5: 2K; R_0805_2012Metric
R9, R12: 200m; R_0805_2012Metric
U6: DRV8833PW; TSSOP-16_4.4x5mm_P0.65mm

Connections:
Card1: J_JST2_2.2, U6.2 (AOUT1)
Card2: J_JST2_2.1, U6.4 (AOUT2)
EN_Card: U6.1 (nSLEEP); also elsewhere on the board
GND_M: C16.1, CE2.2, D4.1 (K), R9.2, R12.2, U6.13 (GND); also elsewhere on the board
Motor_Card_IN1: U6.16 (AIN1); also elsewhere on the board
Motor_Card_IN2: U6.15 (AIN2); also elsewhere on the board
Motor_Soli_IN1: U6.9 (BIN1); also elsewhere on the board
Motor_Soli_IN2: U6.10 (BIN2); also elsewhere on the board
unnamed: C15.2, U6.11 (VCP)
unnamed: C16.2, U6.14 (VINT)
unnamed: D4.2 (A), R5.2
unnamed: R9.1, U6.6 (BISEN)
unnamed: R12.1, U6.3 (AISEN)
Soli1: J_JST2_3.2, U6.7 (BOUT1)
Soli2: J_JST2_3.1, U6.5 (BOUT2)
VM_5V0: C15.1, CE2.1, R5.1, U6.12 (VM); also elsewhere on the board

Notes on the sheet:
https://www.farnell.com/datasheets/3990484.pdf
https://www.ti.com/lit/ds/symlink/drv8833.pdf
https://be.farnell.com/en-BE/multicomp/mm10/motor-miniature-1-5-3-0v-16-3krpm/dp/599104

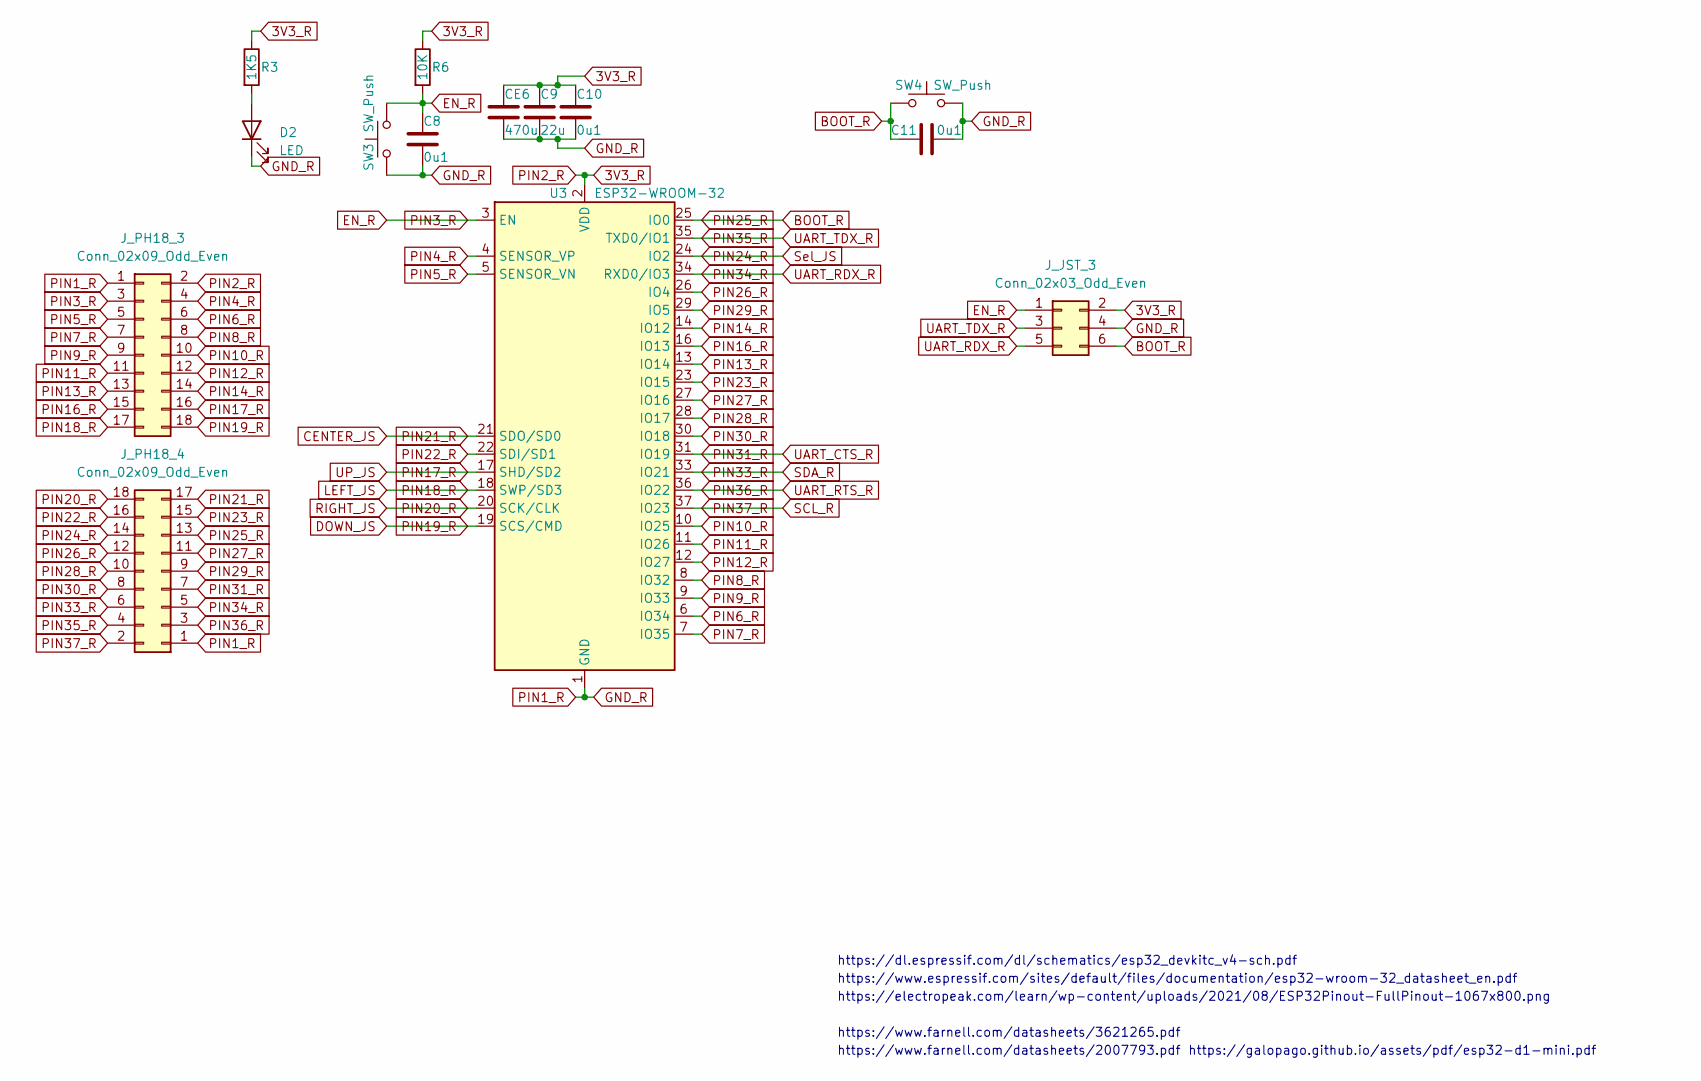
[picture p91: schematic remote_MCU.kicad_sch]

Parts:
C8, C10, C11: 0u1; C_0805_2012Metric
C9: 22u; C_0805_2012Metric
CE6: 470u; CP_Radial_D8.0mm_P3.80mm
D2: LED; LED_0805_2012Metric
J_JST_3: Conn_02x03_Odd_Even; 61200621621
J_PH18_3, J_PH18_4: Conn_02x09_Odd_Even; PinHeader_2x09_P2.54mm_Vertical
R3: 1K5; R_0805_2012Metric
R6: 10K; R_0805_2012Metric
SW3, SW4: SW_Push; SW_SPST_Omron_B3FS-100xP
U3: ESP32-WROOM-32

Connections:
3V3_R: C9.1, C10.1, CE6.1, J_JST_3.2, J_PH18_3.2, R3.1, R6.1, U3.2 (VDD); also elsewhere on the board
BOOT_R: C11.1, J_JST_3.6, J_PH18_4.13, SW4.1, U3.25 (IO0)
CENTER_JS: J_PH18_4.17, U3.21 (SDO/SD0); also elsewhere on the board
DOWN_JS: J_PH18_3.18, U3.19 (SCS/CMD); also elsewhere on the board
EN_R: C8.1, J_JST_3.1, J_PH18_3.3, R6.2, SW3.2, U3.3 (EN)
GND_R: C8.2, C9.2, C10.2, C11.2, CE6.2, D2.1 (K), J_JST_3.4, J_PH18_3.1, J_PH18_4.1, SW3.1, SW4.2, U3.1 (GND), U3.15 (GND), U3.38 (GND), U3.39 (GND); also elsewhere on the board
LEFT_JS: J_PH18_3.17, U3.18 (SWP/SD3); also elsewhere on the board
unnamed: D2.2 (A), R3.2
PIN4_R: J_PH18_3.4, U3.4 (SENSOR_VP)
PIN5_R: J_PH18_3.5, U3.5 (SENSOR_VN)
PIN6_R: J_PH18_3.6, U3.6 (IO34)
PIN7_R: J_PH18_3.7, U3.7 (IO35)
PIN8_R: J_PH18_3.8, U3.8 (IO32)
PIN9_R: J_PH18_3.9, U3.9 (IO33)
PIN10_R: J_PH18_3.10, U3.10 (IO25)
PIN11_R: J_PH18_3.11, U3.11 (IO26)
PIN12_R: J_PH18_3.12, U3.12 (IO27)
PIN13_R: J_PH18_3.13, U3.13 (IO14)
PIN14_R: J_PH18_3.14, U3.14 (IO12)
PIN16_R: J_PH18_3.15, U3.16 (IO13)
PIN17_R: J_PH18_3.16, U3.17 (SHD/SD2); also elsewhere on the board
PIN20_R: J_PH18_4.18, U3.20 (SCK/CLK); also elsewhere on the board
PIN22_R: J_PH18_4.16, U3.22 (SDI/SD1)
PIN23_R: J_PH18_4.15, U3.23 (IO15)
PIN24_R: J_PH18_4.14, U3.24 (IO2)
PIN26_R: J_PH18_4.12, U3.26 (IO4)
PIN27_R: J_PH18_4.11, U3.27 (IO16)
PIN28_R: J_PH18_4.10, U3.28 (IO17)
PIN29_R: J_PH18_4.9, U3.29 (IO5)
PIN30_R: J_PH18_4.8, U3.30 (IO18)
PIN31_R: J_PH18_4.7, U3.31 (IO19)
PIN33_R: J_PH18_4.6, U3.33 (IO21); also elsewhere on the board
PIN34_R: J_JST_3.5, J_PH18_4.5, U3.34 (RXD0/IO3)
PIN35_R: J_JST_3.3, J_PH18_4.4, U3.35 (TXD0/IO1)
PIN36_R: J_PH18_4.3, U3.36 (IO22)
PIN37_R: J_PH18_4.2, U3.37 (IO23); also elsewhere on the board

Notes on the sheet:
https://electropeak.com/learn/wp-content/uploads/2021/08/ESP32Pinout-FullPinout-1067x800.png
https://www.espressif.com/sites/default/files/documentation/esp32-wroom-32_datasheet_en.pdf
https://www.farnell.com/datasheets/2007793.pdf
https://dl.espressif.com/dl/schematics/esp32_devkitc_v4-sch.pdf
https://www.farnell.com/datasheets/3621265.pdf
https://galopago.github.io/assets/pdf/esp32-d1-mini.pdf

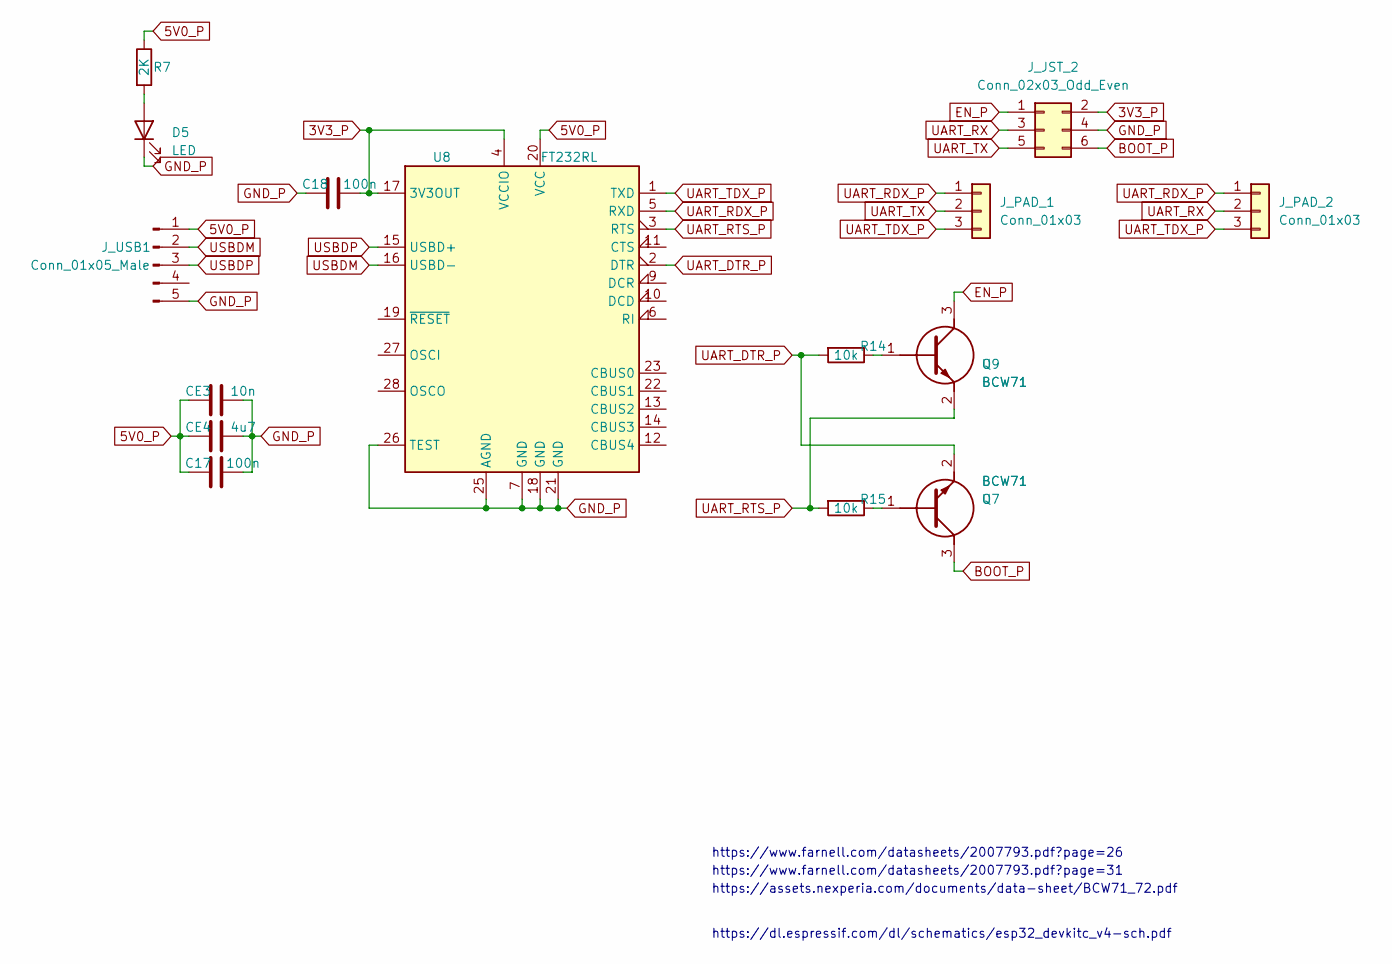
[picture p92: schematic programmer.kicad_sch]

Parts:
C17, C18: 100n; C_0805_2012Metric
CE3: 10n; C_0805_2012Metric
CE4: 4u7; CP_Radial_D5.0mm_P2.00mm
D5: LED; LED_0805_2012Metric
J_JST_2: Conn_02x03_Odd_Even; 61300621821
J_PAD_1, J_PAD_2: Conn_01x03; SolderJumper-3_P2.0mm_Open_TrianglePad1.0x1.5mm_NumberLabels
J_USB1: Conn_01x05_Male; PinHeader_1x05_P2.54mm_Vertical
R7: 2K; R_0805_2012Metric
R14, R15: 10k; R_0805_2012Metric
U7, U9: BCW71; SOT95P230X110-3N; Manufacturer_Part_Number BCW71; Mouser Part Number 512-BCW71
U8: FT232RL; SSOP-28_5.3x10.2mm_P0.65mm

Connections:
3V3_P: C18.2, J_JST_2.2, U8.4 (VCCIO), U8.17 (3V3OUT)
5V0_P: C17.1, CE3.1, CE4.1, J_USB1.1, R7.1, U8.20 (VCC)
BOOT_P: J_JST_2.6, U7.3 (C)
EN_P: J_JST_2.1, U9.3 (C)
GND_P: C17.2, C18.1, CE3.2, CE4.2, D5.1 (K), J_JST_2.4, J_USB1.5, U8.7 (GND), U8.18 (GND), U8.21 (GND), U8.25 (AGND), U8.26 (TEST)
unnamed: D5.2 (A), R7.2
unnamed: R14.1, U9.1 (B)
unnamed: R15.1, U7.1 (B)
UART_DTR_P: R14.2, U7.2 (E), U8.2 (DTR)
UART_RDX_P: J_PAD_1.1, J_PAD_2.1, U8.5 (RXD)
UART_RTS_P: R15.2, U8.3 (RTS), U9.2 (E)
UART_RX: J_JST_2.3, J_PAD_2.2
UART_TDX_P: J_PAD_1.3, J_PAD_2.3, U8.1 (TXD)
UART_TX: J_JST_2.5, J_PAD_1.2
USBDM: J_USB1.2, U8.16 (USBD-)
USBDP: J_USB1.3, U8.15 (USBD+)

Notes on the sheet:
https://assets.nexperia.com/documents/data-sheet/BCW71_72.pdf
https://www.farnell.com/datasheets/2007793.pdf?page=26
https://dl.espressif.com/dl/schematics/esp32_devkitc_v4-sch.pdf
https://www.farnell.com/datasheets/2007793.pdf?page=31

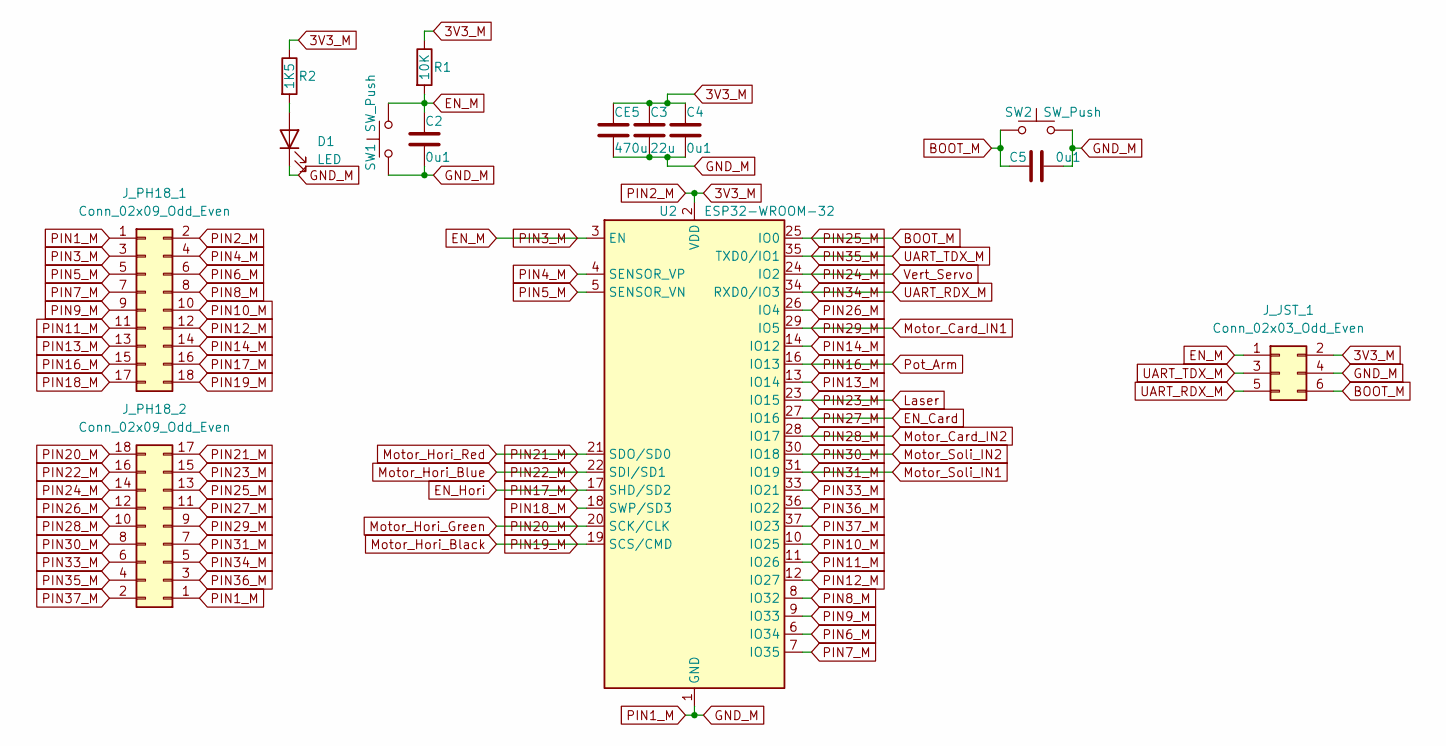
[picture p93: schematic module_MCU.kicad_sch]

Parts:
C2, C4, C5: 0u1; C_0805_2012Metric
C3: 22u; C_0805_2012Metric
CE5: 470u; CP_Radial_D8.0mm_P3.80mm
D1: LED; LED_0805_2012Metric
J_JST_1: Conn_02x03_Odd_Even; 61200621621
J_PH18_1, J_PH18_2: Conn_02x09_Odd_Even; PinHeader_2x09_P2.54mm_Vertical
R1: 10K; R_0805_2012Metric
R2: 1K5; R_0805_2012Metric
SW1, SW2: SW_Push; SW_SPST_Omron_B3FS-100xP
U2: ESP32-WROOM-32

Connections:
3V3_M: C3.1, C4.1, CE5.1, J_JST_1.2, J_PH18_1.2, R1.1, R2.1, U2.2 (VDD); also elsewhere on the board
BOOT_M: C5.1, J_JST_1.6, J_PH18_2.13, SW2.1, U2.25 (IO0)
EN_Card: J_PH18_2.11, U2.27 (IO16); also elsewhere on the board
EN_Hori: J_PH18_1.16, U2.17 (SHD/SD2); also elsewhere on the board
EN_M: C2.1, J_JST_1.1, J_PH18_1.3, R1.2, SW1.2, U2.3 (EN)
GND_M: C2.2, C3.2, C4.2, C5.2, CE5.2, D1.1 (K), J_JST_1.4, J_PH18_1.1, J_PH18_2.1, SW1.1, SW2.2, U2.1 (GND), U2.15 (GND), U2.38 (GND), U2.39 (GND); also elsewhere on the board
Laser: J_PH18_2.15, U2.23 (IO15); also elsewhere on the board
Motor_Card_IN1: J_PH18_2.9, U2.29 (IO5); also elsewhere on the board
Motor_Card_IN2: J_PH18_2.10, U2.28 (IO17); also elsewhere on the board
Motor_Hori_Black: J_PH18_1.18, U2.19 (SCS/CMD); also elsewhere on the board
Motor_Hori_Blue: J_PH18_2.16, U2.22 (SDI/SD1); also elsewhere on the board
Motor_Hori_Green: J_PH18_2.18, U2.20 (SCK/CLK); also elsewhere on the board
Motor_Hori_Red: J_PH18_2.17, U2.21 (SDO/SD0); also elsewhere on the board
Motor_Soli_IN1: J_PH18_2.7, U2.31 (IO19); also elsewhere on the board
Motor_Soli_IN2: J_PH18_2.8, U2.30 (IO18); also elsewhere on the board
unnamed: D1.2 (A), R2.2
PIN4_M: J_PH18_1.4, U2.4 (SENSOR_VP)
PIN5_M: J_PH18_1.5, U2.5 (SENSOR_VN)
PIN6_M: J_PH18_1.6, U2.6 (IO34)
PIN7_M: J_PH18_1.7, U2.7 (IO35)
PIN8_M: J_PH18_1.8, U2.8 (IO32)
PIN9_M: J_PH18_1.9, U2.9 (IO33)
PIN10_M: J_PH18_1.10, U2.10 (IO25)
PIN11_M: J_PH18_1.11, U2.11 (IO26)
PIN12_M: J_PH18_1.12, U2.12 (IO27)
PIN13_M: J_PH18_1.13, U2.13 (IO14)
PIN14_M: J_PH18_1.14, U2.14 (IO12)
PIN16_M: J_PH18_1.15, U2.16 (IO13); also elsewhere on the board
PIN18_M: J_PH18_1.17, U2.18 (SWP/SD3)
PIN24_M: J_PH18_2.14, U2.24 (IO2); also elsewhere on the board
PIN26_M: J_PH18_2.12, U2.26 (IO4)
PIN33_M: J_PH18_2.6, U2.33 (IO21)
PIN34_M: J_JST_1.5, J_PH18_2.5, U2.34 (RXD0/IO3)
PIN35_M: J_JST_1.3, J_PH18_2.4, U2.35 (TXD0/IO1)
PIN36_M: J_PH18_2.3, U2.36 (IO22)
PIN37_M: J_PH18_2.2, U2.37 (IO23)

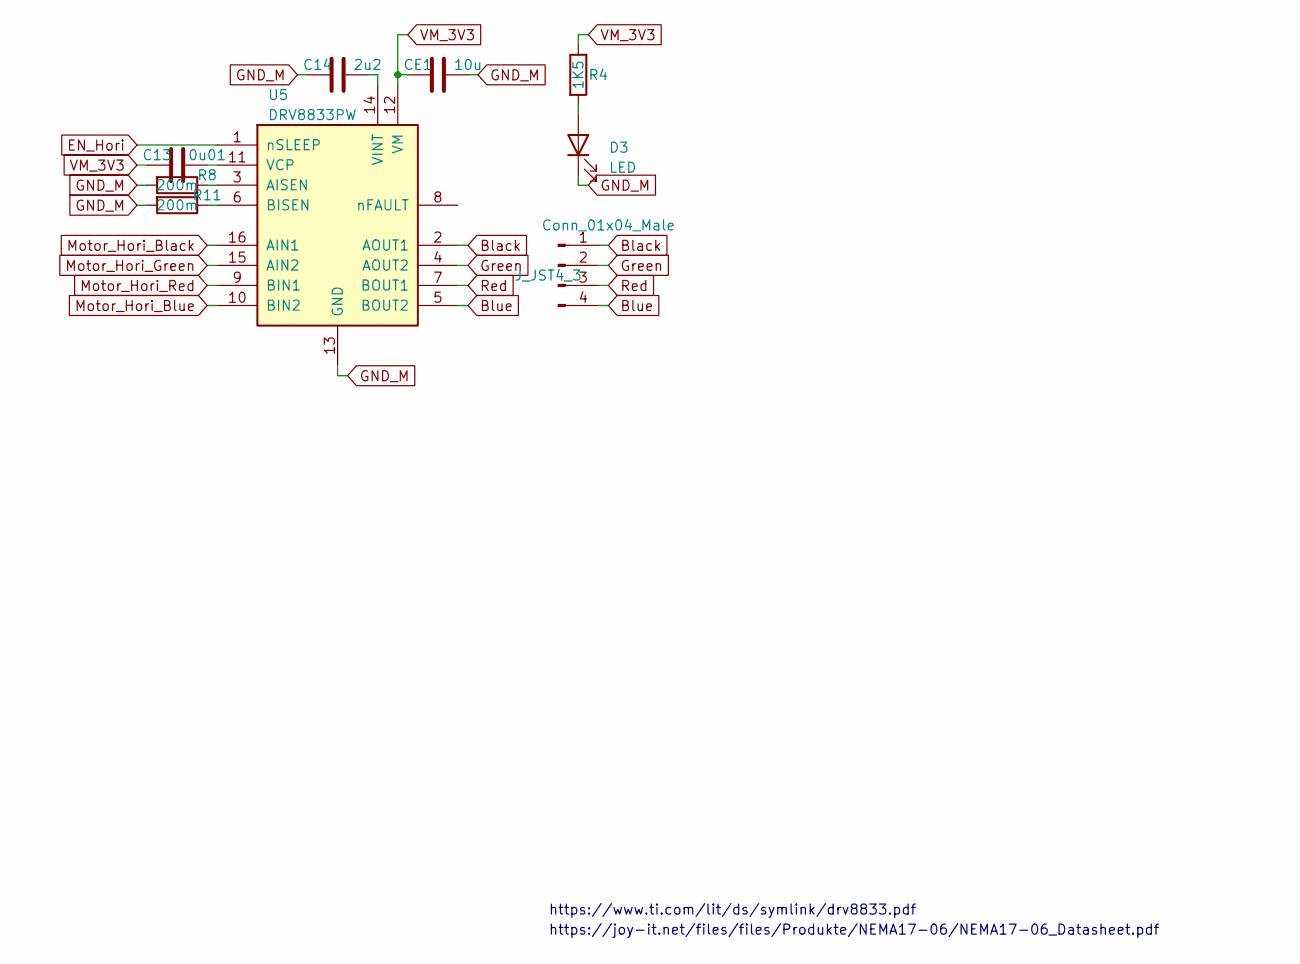
[picture p94: schematic hori_motor.kicad_sch]

Parts:
C13: 0u01; C_0805_2012Metric
C14: 2u2; C_0805_2012Metric
CE1: 10u; CP_Radial_D5.0mm_P2.50mm
D3: LED; LED_0805_2012Metric
J_JST4_3: Conn_01x04_Male; JST_XH_B4B-XH-A_1x04_P2.50mm_Vertical
R4: 1K5; R_0805_2012Metric
R8, R11: 200m; R_0805_2012Metric
U5: DRV8833PW; TSSOP-16_4.4x5mm_P0.65mm

Connections:
Black: J_JST4_3.1, U5.2 (AOUT1)
Blue: J_JST4_3.4, U5.5 (BOUT2)
EN_Hori: U5.1 (nSLEEP); also elsewhere on the board
GND_M: C14.1, CE1.2, D3.1 (K), R8.2, R11.2, U5.13 (GND); also elsewhere on the board
Green: J_JST4_3.2, U5.4 (AOUT2)
Motor_Hori_Black: U5.16 (AIN1); also elsewhere on the board
Motor_Hori_Blue: U5.10 (BIN2); also elsewhere on the board
Motor_Hori_Green: U5.15 (AIN2); also elsewhere on the board
Motor_Hori_Red: U5.9 (BIN1); also elsewhere on the board
unnamed: C13.2, U5.11 (VCP)
unnamed: C14.2, U5.14 (VINT)
unnamed: D3.2 (A), R4.2
unnamed: R8.1, U5.3 (AISEN)
unnamed: R11.1, U5.6 (BISEN)
Red: J_JST4_3.3, U5.7 (BOUT1)
VM_3V3: C13.1, CE1.1, R4.1, U5.12 (VM); also elsewhere on the board

Notes on the sheet:
https://www.ti.com/lit/ds/symlink/drv8833.pdf
https://joy-it.net/files/files/Produkte/NEMA17-06/NEMA17-06_Datasheet.pdf

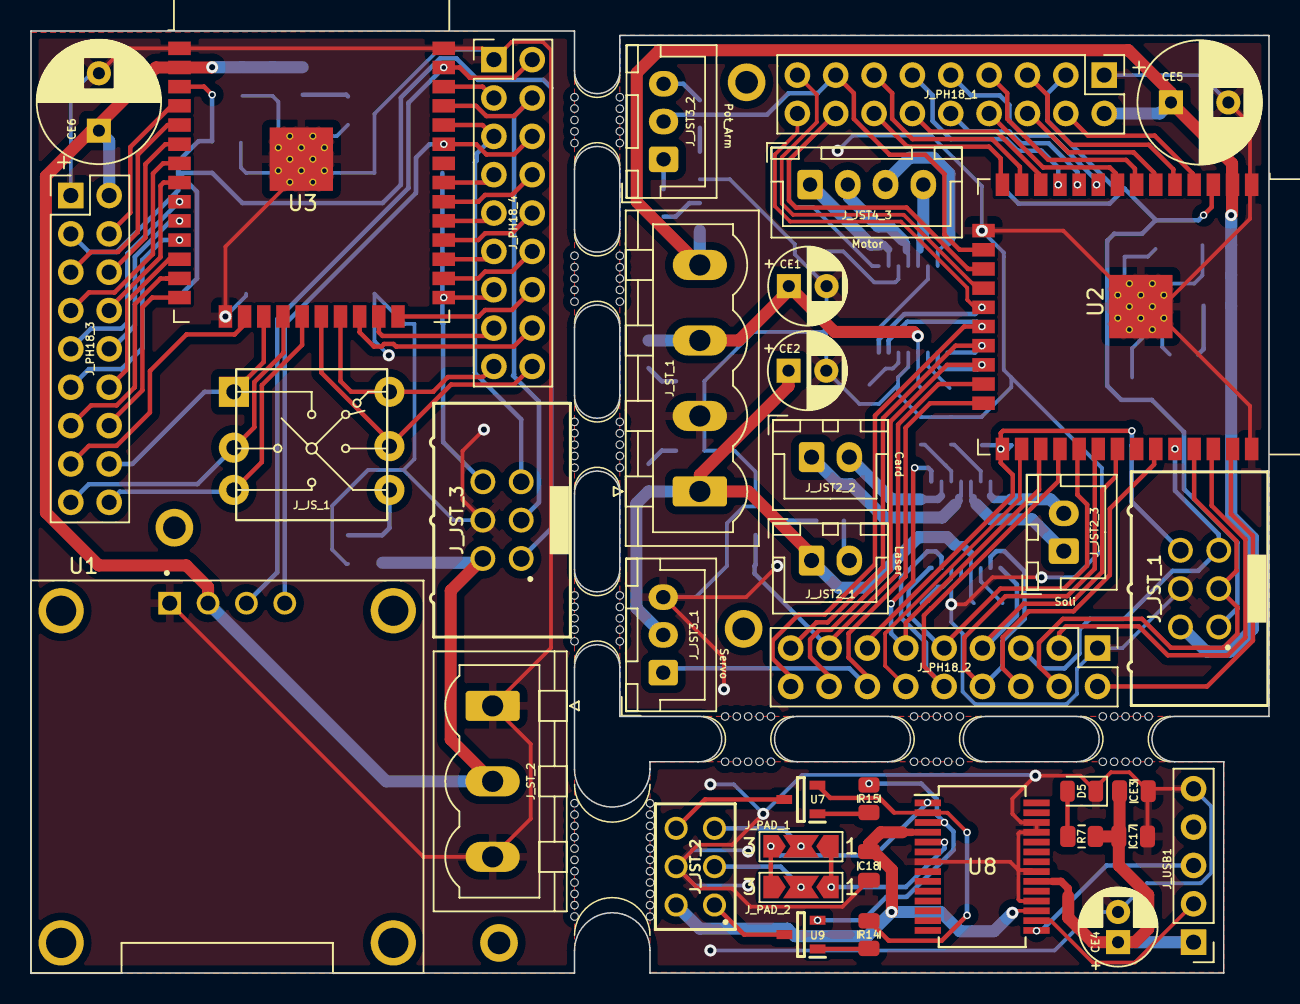
[picture p95: board kaarten_shieter.kicad_pcb from above]

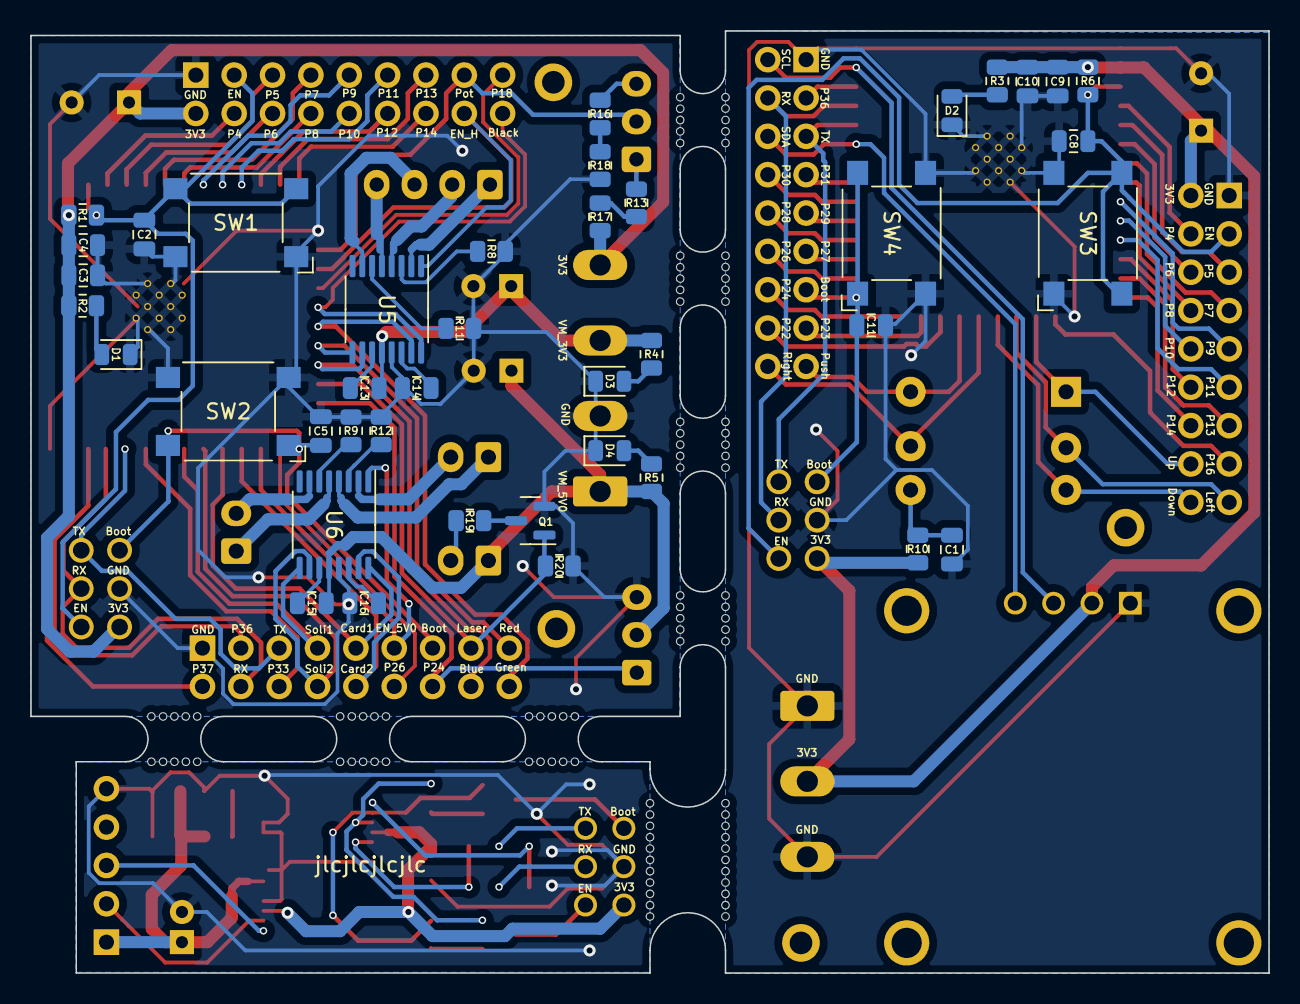
[picture p96: board kaarten_shieter.kicad_pcb from below]

Board: 2 copper layers, 82.0 x 62.4 mm, 86 parts (41 on the bottom side), 115 nets.

Other parts of the board:
mouse-bite-5mm-slot, mouse-bite-5mm-slot#3, mouse-bite-5mm-slot#4, mouse-bite-5mm-slot#5, mouse-bite-5mm-slot#6, mouse-bite-5mm-slot#7, mouse-bite-5mm-slot#8: VAL**; mouse-bite-3mm-slot
mouse-bite-5mm-slot#2: VAL**; mouse-bite-5mm-slot
