ThomasKramp/kaarten_shieter/(commit log)

2024-11-21 version 1
    [school_componenten.xlsx]
2024-11-21 version 2
    [kaarten_shieter-B_Cu.gbl, kaarten_shieter-B_Cu.gbr, kaarten_shieter-B_Mask.gbr, kaarten_shieter-B_Mask.gbs, kaarten_shieter-B_Paste.gbp, kaarten_shieter-B_Paste.gbr, kaarten_shieter-B_Silkscreen.gbo, kaarten_shieter-B_Silkscreen.gbr]
2024-11-21 version 3
    [kaarten_shieter-B_Cu.gbl, kaarten_shieter-B_Cu.gbr, kaarten_shieter-B_Mask.gbr, kaarten_shieter-B_Mask.gbs, kaarten_shieter-B_Paste.gbp, kaarten_shieter-B_Paste.gbr, kaarten_shieter-B_Silkscreen.gbo, kaarten_shieter-B_Silkscreen.gbr]
2024-11-21 version 4
    [card_motor.kicad_sch, hori_motor.kicad_sch, joystick.kicad_sch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]
2024-11-21 add casing files
    [0_casing.3mf, 0_casing.scad, 0_corner_cutout.scad, 1_0_box.scad, 1_0_box.stl, 1_1_motor.scad, 1_2_battery.scad, 1_3_charger.scad]
2025-01-09 docs to english
    [0_casing.scad, 0_corner_cutout.scad, 0_settings.scad, 1_0_box.scad, 1_0_box.stl, 1_1_motor.scad, 1_2_battery.scad, 1_3_charger.scad]
2025-01-11 add last problem and solution
    [2_bluetooth_aim.ino]
